GiovanniRaseraF/DroneTheory/Images/JeepRadiocomandata/Wiring.png

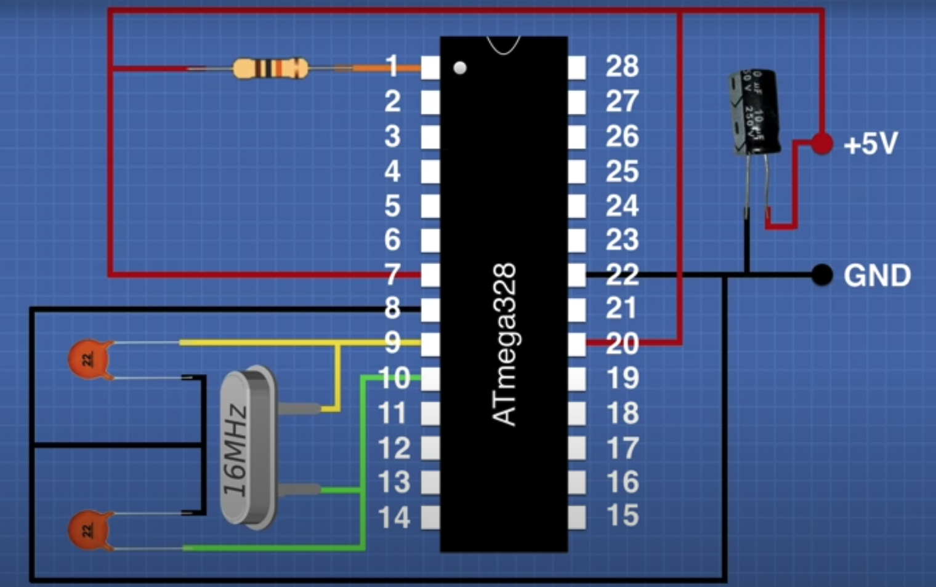
Images/JeepRadiocomandata/Wiring.png
