GiovanniRaseraF/DroneTheory/JeppRadiocomandataARDUINO/Schematica.jpeg

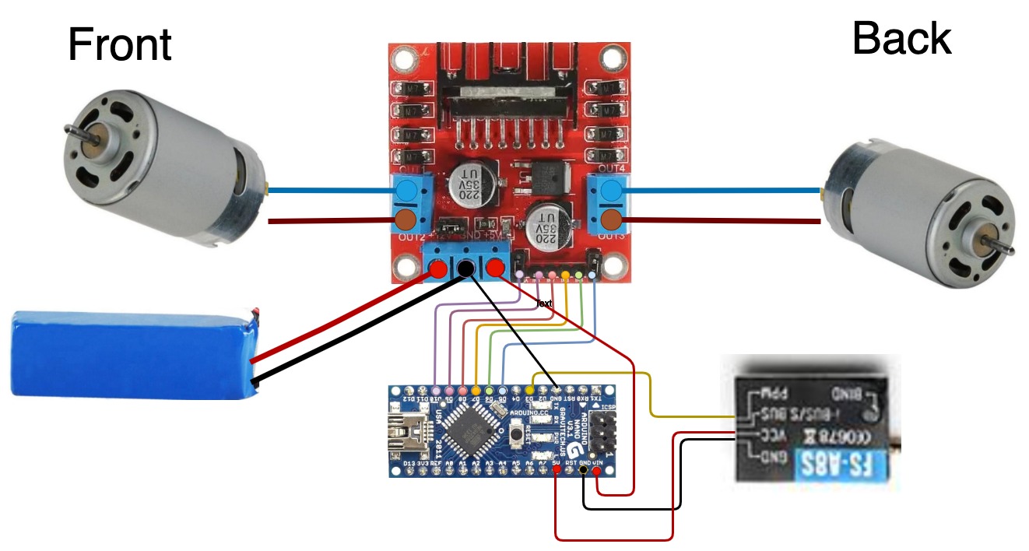
JeppRadiocomandataARDUINO/Schematica.jpeg
