GiovanniRaseraF/DroneTheory/README.md

# DroneTheory

Teoria e creazione di Flight Controller

Testing di ArduPilot
  - Creazione di un thread a 1Hz di esempio
  - Creazione di un esempio con hal.scheduler->register_timer_process(..)
  - RTOS 
  - DevCall Seguita 2022-08-16
