GiovanniRaseraF/DroneTheory/DronePCB/Vespin2/README.md

# Vespin 2.0

## Specifiche
- Convertitore da 5V a 3.3V
- Scheda PCB più grande
- PAD di connessione PWM e UART più grandi
- Test pad per la maggior parte delle connessioni 
- SWD con pad grandi per poter connettere i fili di debug
- Utilizzo di componenti 0603 oppure 0804 in modo da poterli saldare a mano

- Spostare la USB nella parte destra del processore in modo da non farla accavallare
- Connettere il giroscopio MPU6050, siccome costa 5 Euro su Amazon

- Passaggio ESP32 per comodità
