GiovanniRaseraF/DroneTheory/Ideas/prerequirements.md

# Prerequisiti

- Test del comando astyle
- Creazione del server per i test di CI
    - Probabilmente utilizzando docker per permettere di avere una VM più velocemente
- Capire come eseguire i test di compilazione nella macchina virtuale

# Arm ToolChain 
- File possibile per caricare la toolchain di arm [ToolChain](https://gist.github.com/ryankurte/bab66362f0c23d3a1916)
- Far funzionare la toolchain ed il download di essa
