GiovanniRaseraF/DroneTheory/Docs/publications.md

# Pubblicazioni che hanno contribuito
- [Alessandro Minervini, Development of an Open-Source Flight Controller for Rotary Wing UAVs. Rel. Giorgio Guglieri, Simone Godio. Politecnico di Torino, Corso di laurea magistrale in Ingegneria Aerospaziale, 2021](https://webthesis.biblio.polito.it/18388/)
  - Sull'intero lavoro
  - Sul codice sorgente
  - Funzioni di trasferimento del sistema di volo

- [Alessandro Lorenzini](https://github.com/alelore6)
  - Adattamento del file downlaod.sh 
  - Test per il download della toolchain arm

- [Matej Blagšič](https://github.com/prtzl)
  - Scrittura del file di configurazione della toolchain 
  - File cmake, make che permette di compilare i progetti STM32 da terminale usando cmake

- [Ryan](https://gist.github.com/ryankurte)
  - Scrittura del file di download.sh per il download della toolchain arm-none-eabi

- [PWM](https://www.google.com/search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)
  - Lezione sull'utilizzo del protocollo PWM su stm32

- [Collegamento FS-A8S](https://youtu.be/RERBbO7auhA)
  - Collegamento cavi a OMNIBUSF4 e impostazioni

- [Lettura PPM da radio trasmittente](https://github.com/dimag0g/PPM-reader)
  - Lettura del segnale e dei canali

- [ExpressLRS](https://github.com/ExpressLRS/ExpressLRS)
  - Protocollo di comunicazione open-source

- [ArduPilot](https://ardupilot.org/)
  - Firmware di volo
