GiovanniRaseraF/DroneTheory/Docs/RegoleDiVolo_A1+A3.pdf

# REQUEST FORM

### Request ID 332281

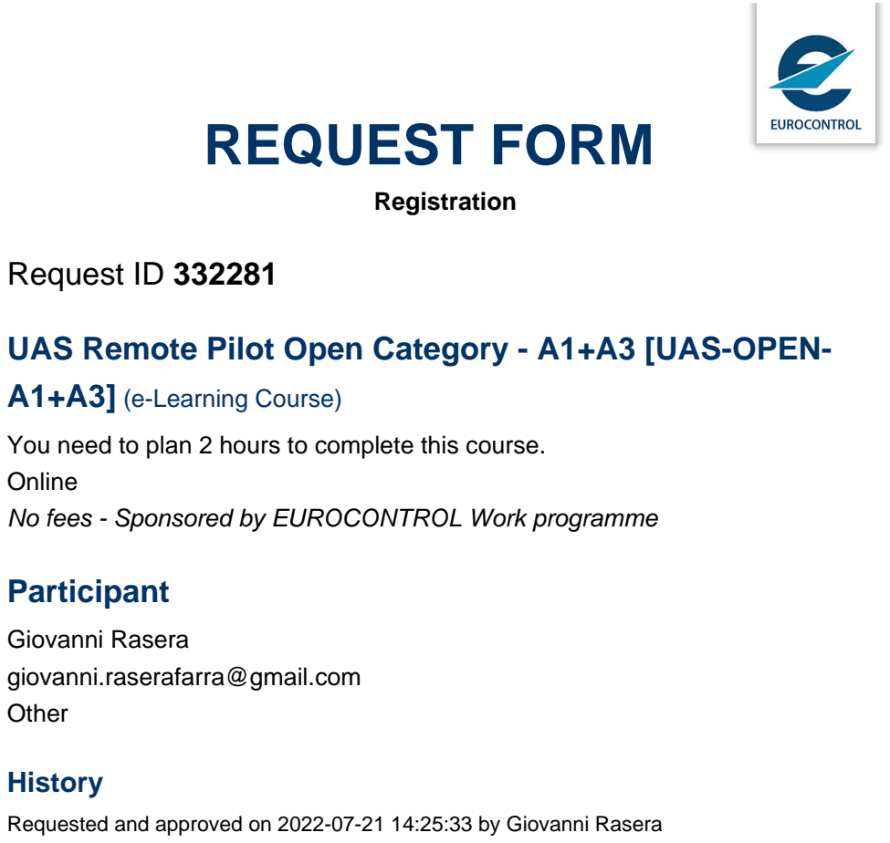
[picture p3: page 1]

Registration

## UAS Remote Pilot Open Category - A1+A3 [UAS-OPEN-

A1+A3] (e-Learning Course)

You need to plan 2 hours to complete this course.
Online
No fees - Sponsored by EUROCONTROL Work programme

## Participant

Giovanni Rasera
giovanni.raserafarra@gmail.com Other

History

Requested and approved on 2022-07-21 14:25:33 by Giovanni Rasera
