GiovanniRaseraF/DroneTheory/DronePCB/Images/AcquistoSchedaVespin1.0.PNG

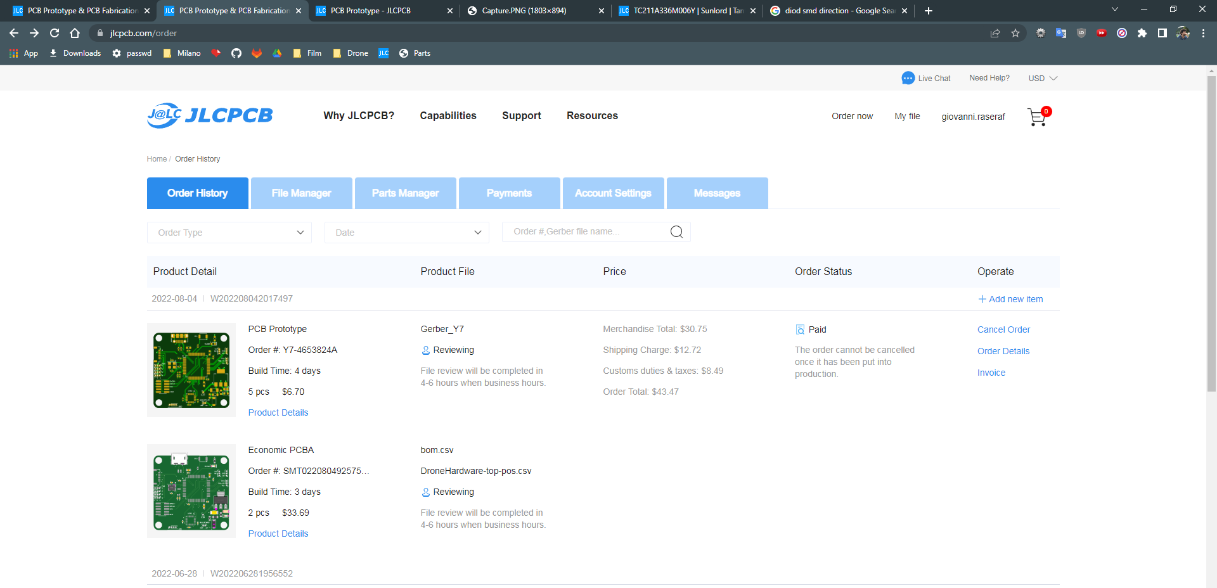
DronePCB/Images/AcquistoSchedaVespin1.0.PNG
