GiovanniRaseraF/DroneTheory/DronePCB/Images/Collegamento12Ve5V.PNG

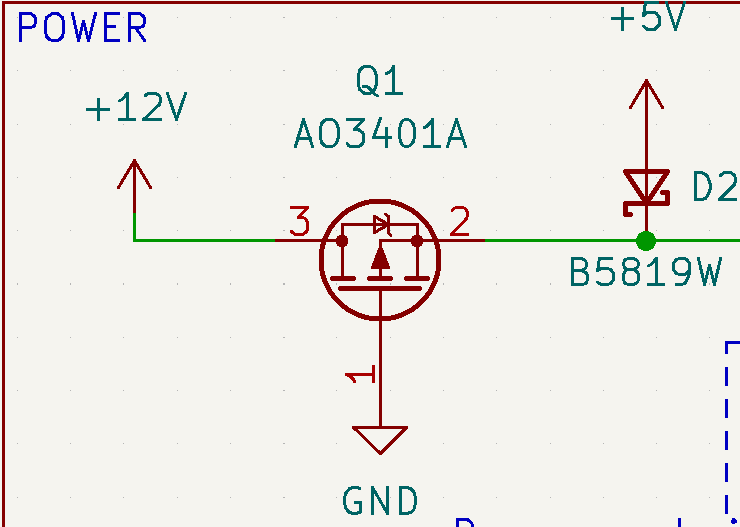
DronePCB/Images/Collegamento12Ve5V.PNG
