GiovanniRaseraF/DroneTheory/DronePCB/Images/LayoutProcessore.png

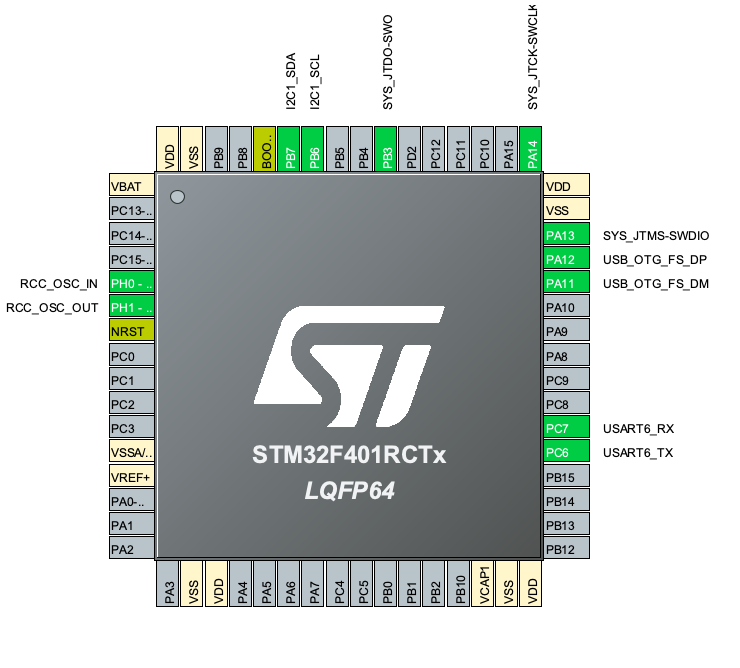
DronePCB/Images/LayoutProcessore.png
