GiovanniRaseraF/DroneTheory/DronePCB/Images/SWD_PIOUT.png

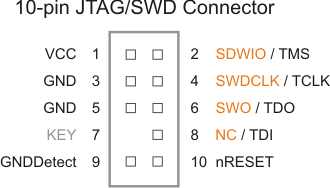
DronePCB/Images/SWD_PIOUT.png
