GiovanniRaseraF/DroneTheory/DronePCB/Manuals/STM32F405RGT6Pinout.png

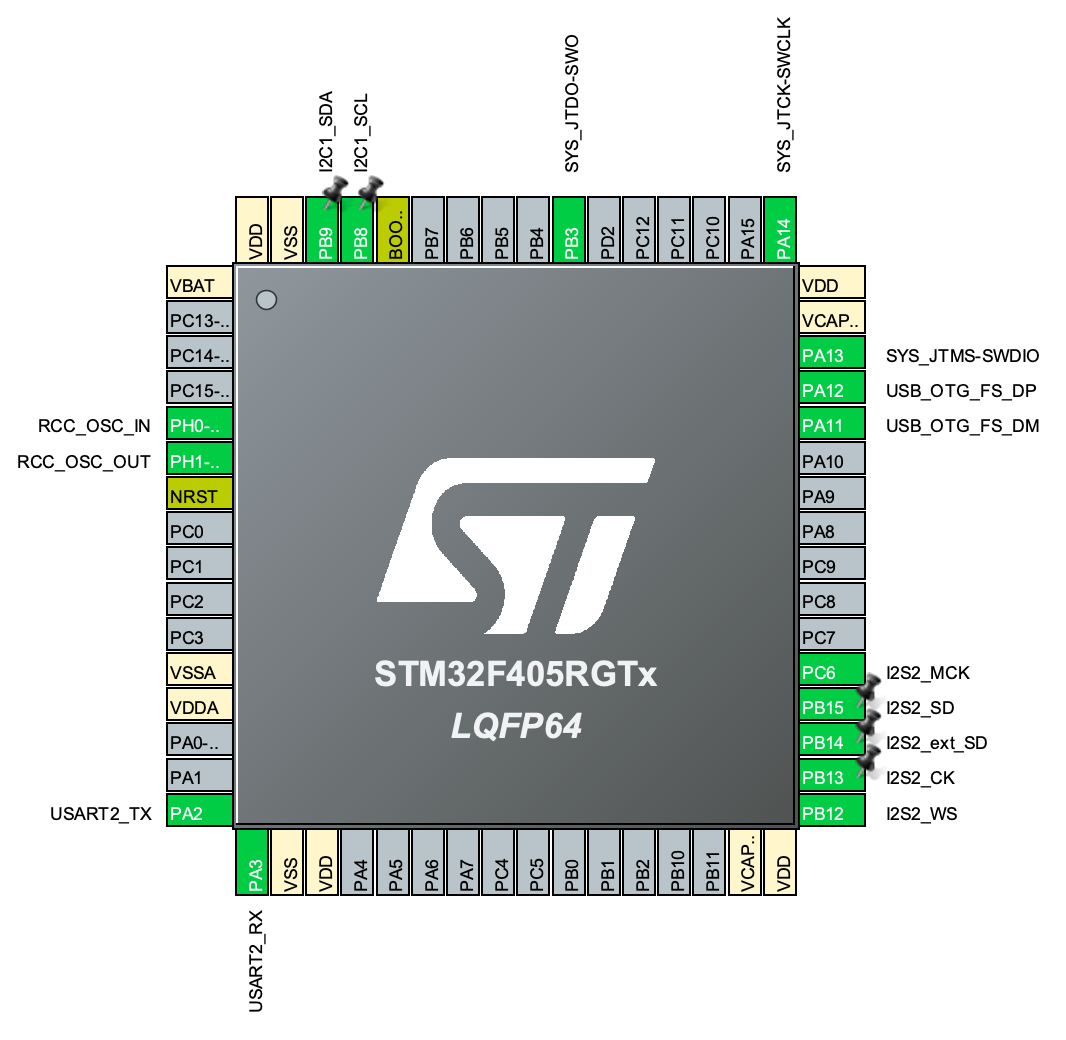
DronePCB/Manuals/STM32F405RGT6Pinout.png
