GiovanniRaseraF/DroneTheory/Images/JeepRadiocomandata/ArduinoNano.jpeg

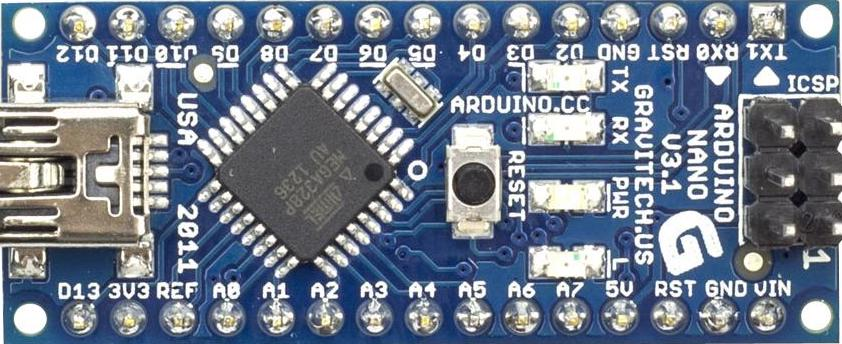
Images/JeepRadiocomandata/ArduinoNano.jpeg
