GiovanniRaseraF/DroneTheory/Images/JeepRadiocomandata/Battery.png

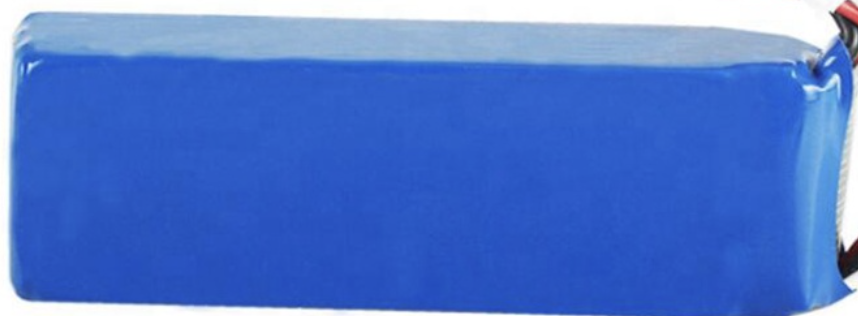
Images/JeepRadiocomandata/Battery.png
