GiovanniRaseraF/DroneTheory/Images/JeepRadiocomandata/collegamenti2.jpg

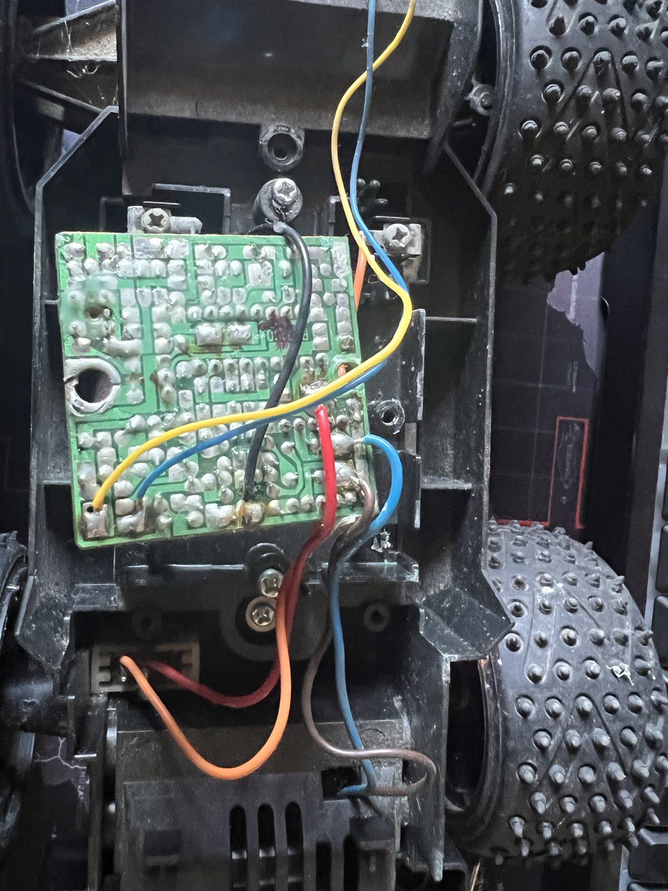
Images/JeepRadiocomandata/collegamenti2.jpg
