GiovanniRaseraF/DroneTheory/Images/JeepRadiocomandata/collegamenti.jpg

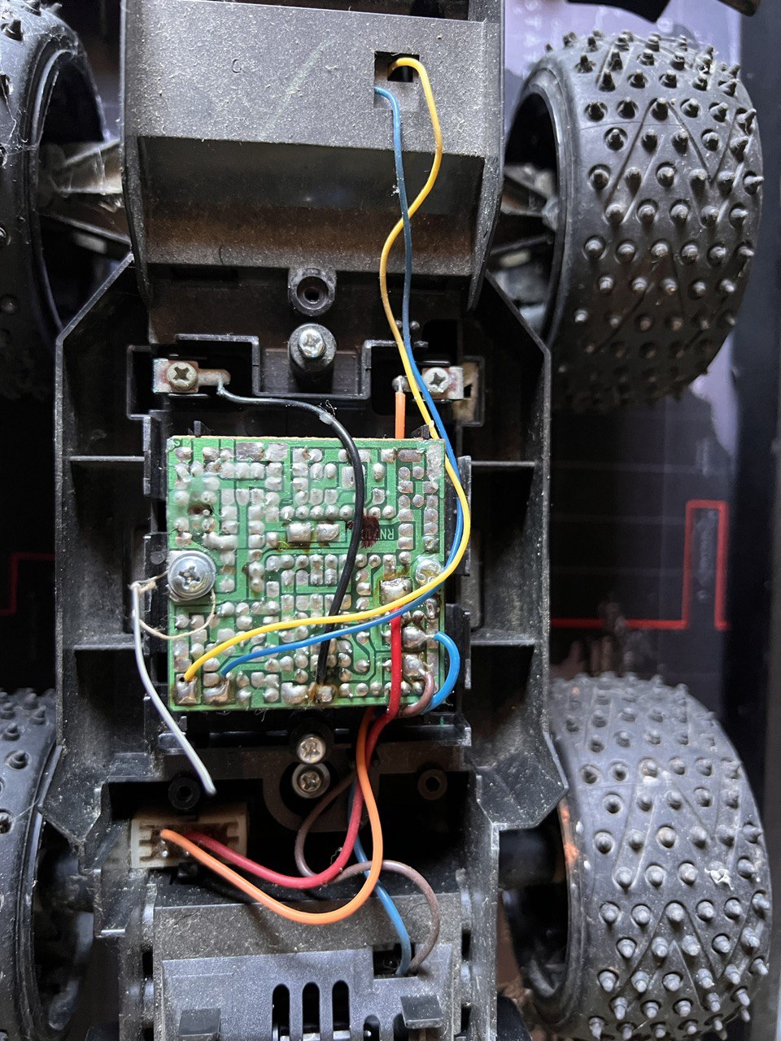
Images/JeepRadiocomandata/collegamenti.jpg
