GiovanniRaseraF/DroneTheory/Images/JeepRadiocomandata/CollegamentoATmega328.png

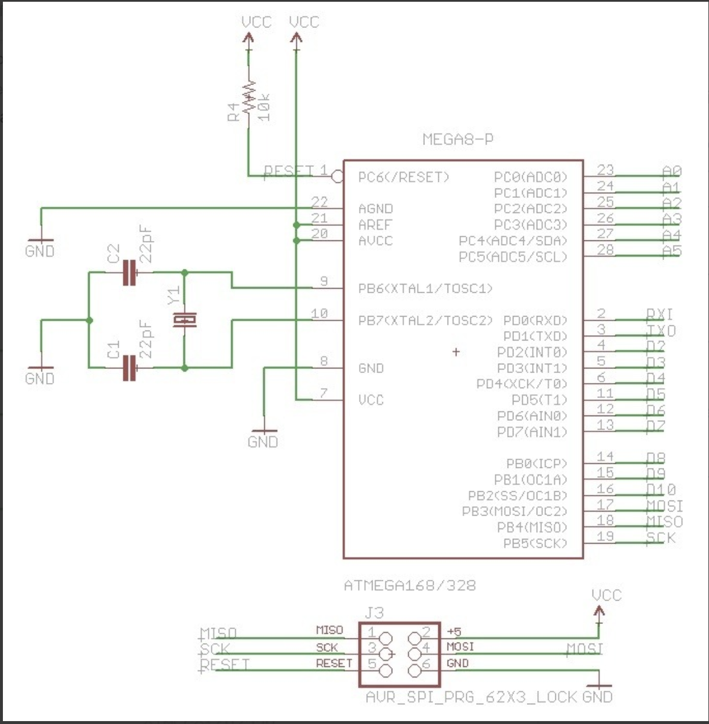
Images/JeepRadiocomandata/CollegamentoATmega328.png
