GiovanniRaseraF/DroneTheory/Images/JeepRadiocomandata/DriverMotoreBack.jpg

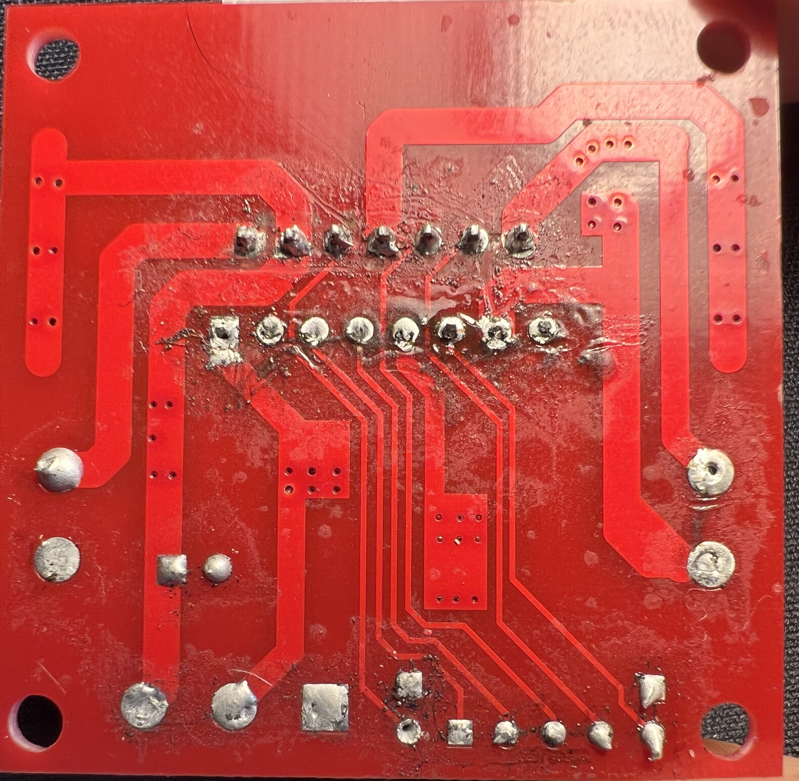
Images/JeepRadiocomandata/DriverMotoreBack.jpg
