GiovanniRaseraF/DroneTheory/Images/JeepRadiocomandata/DriverMotoreFront.jpg

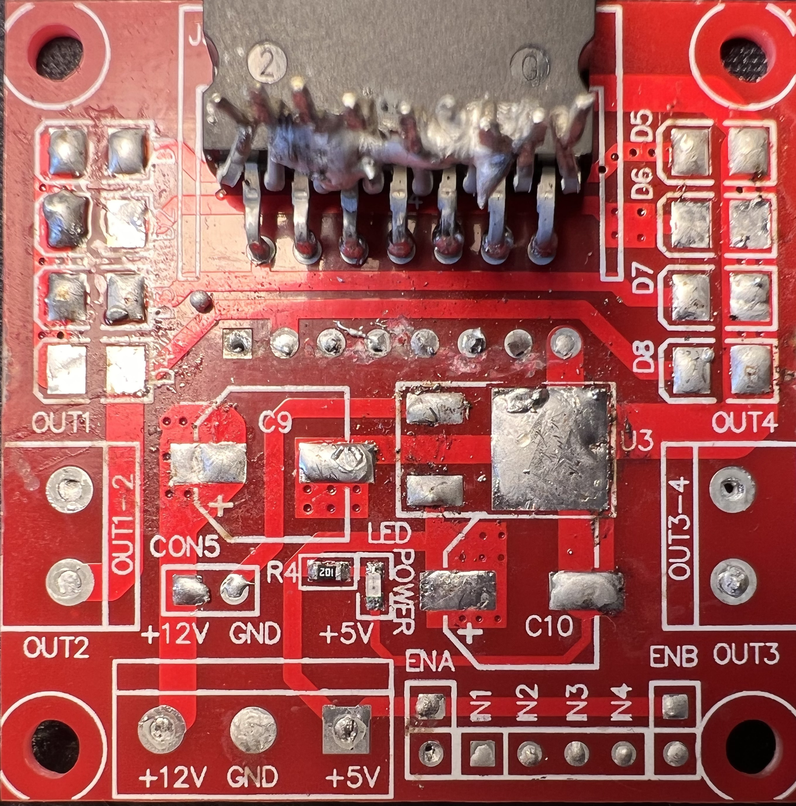
Images/JeepRadiocomandata/DriverMotoreFront.jpg
