GiovanniRaseraF/DroneTheory/Images/JeepRadiocomandata/FS-A8S.png

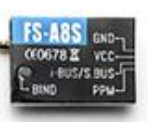
Images/JeepRadiocomandata/FS-A8S.png
