GiovanniRaseraF/DroneTheory/Images/JeepRadiocomandata/jeppRadiocomandataArduino.jpg

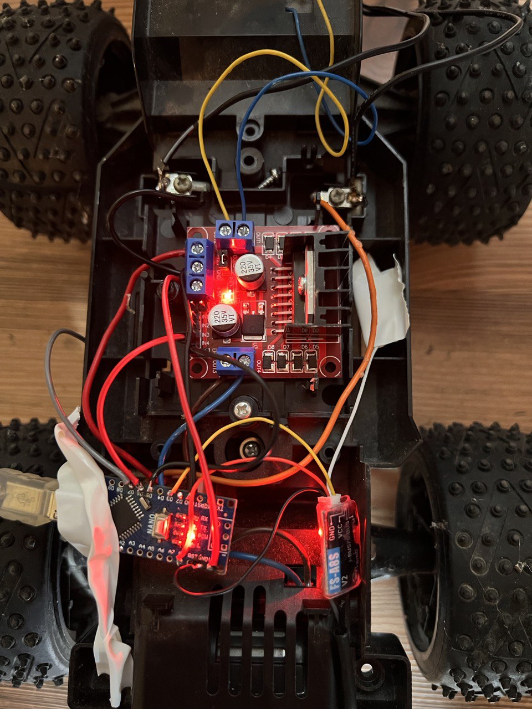
Images/JeepRadiocomandata/jeppRadiocomandataArduino.jpg
