GiovanniRaseraF/DroneTheory/Images/JeepRadiocomandata/L298NModulo.jpg

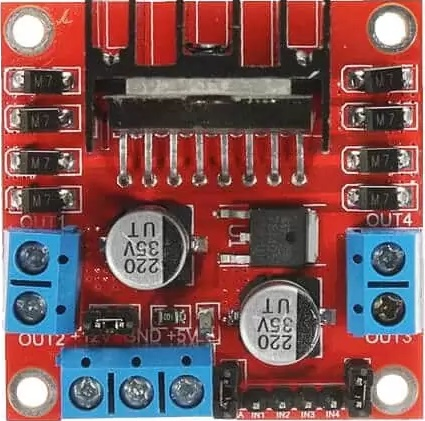
Images/JeepRadiocomandata/L298NModulo.jpg
