GiovanniRaseraF/DroneTheory/Images/JeepRadiocomandata/L298NModuloSchematica.png

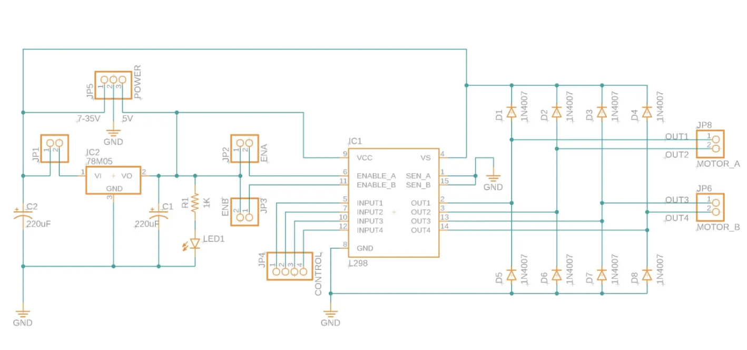
Images/JeepRadiocomandata/L298NModuloSchematica.png
