GiovanniRaseraF/DroneTheory/Images/JeepRadiocomandata/Motor.png

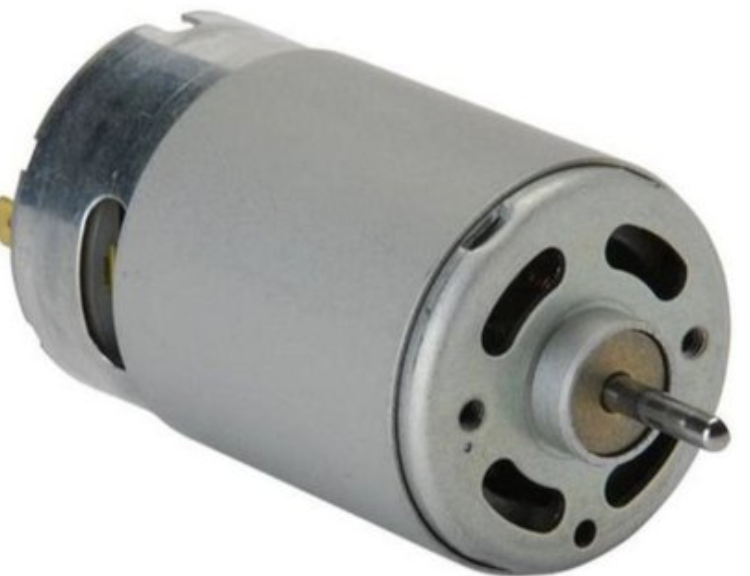
Images/JeepRadiocomandata/Motor.png
