GiovanniRaseraF/DroneTheory/Images/MatekF405/matekf405.jpeg

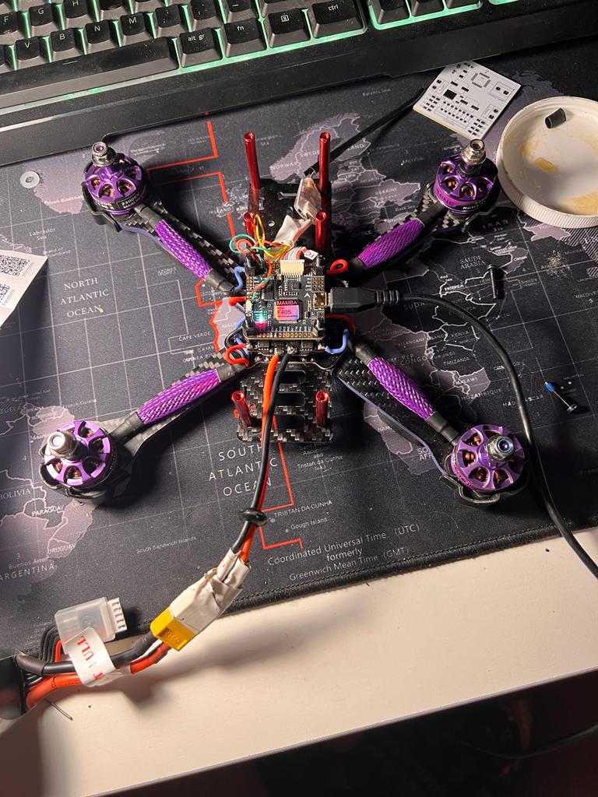
Images/MatekF405/matekf405.jpeg
