GiovanniRaseraF/DroneTheory/Images/taillessplane.png

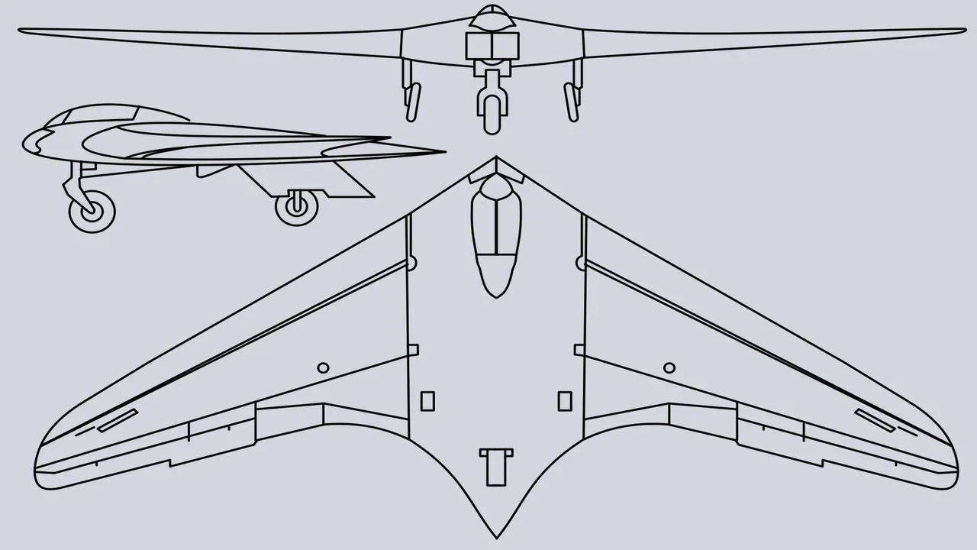
Images/taillessplane.png
