GiovanniRaseraF/DroneTheory/Images/VespinVer1.0/PCBBack.PNG

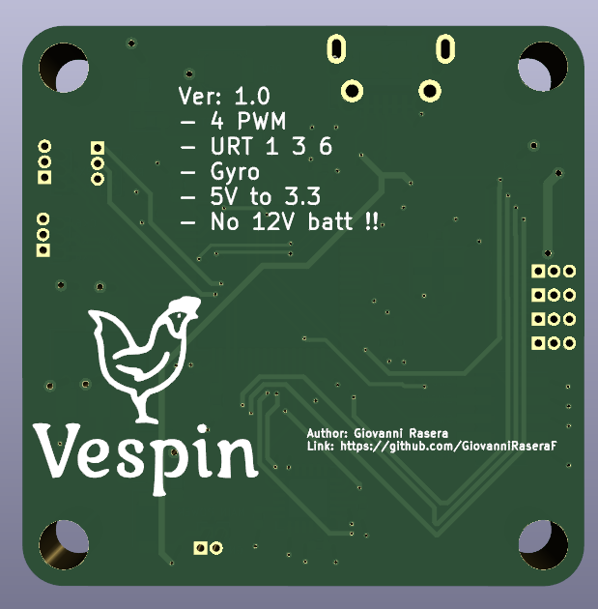
Images/VespinVer1.0/PCBBack.PNG
