GiovanniRaseraF/DroneTheory/Images/VespinVer1.0/PCBFront.PNG

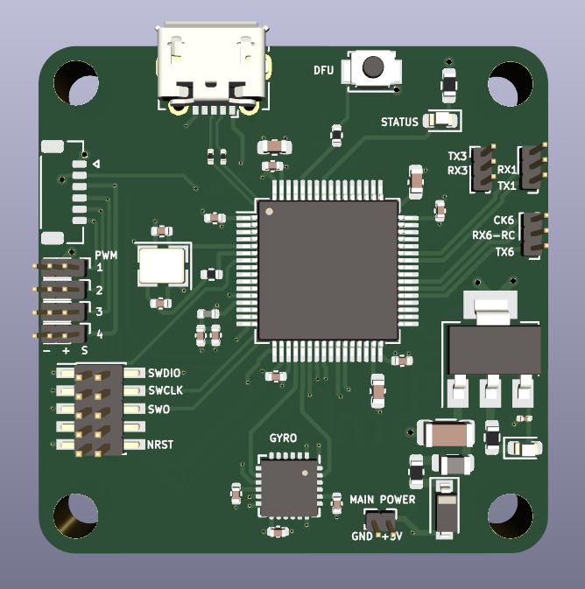
Images/VespinVer1.0/PCBFront.PNG
