GiovanniRaseraF/DroneTheory/JeppRadiocomandataARDUINO/Hardware/1.0.0/Front_JeepPCB.jpg

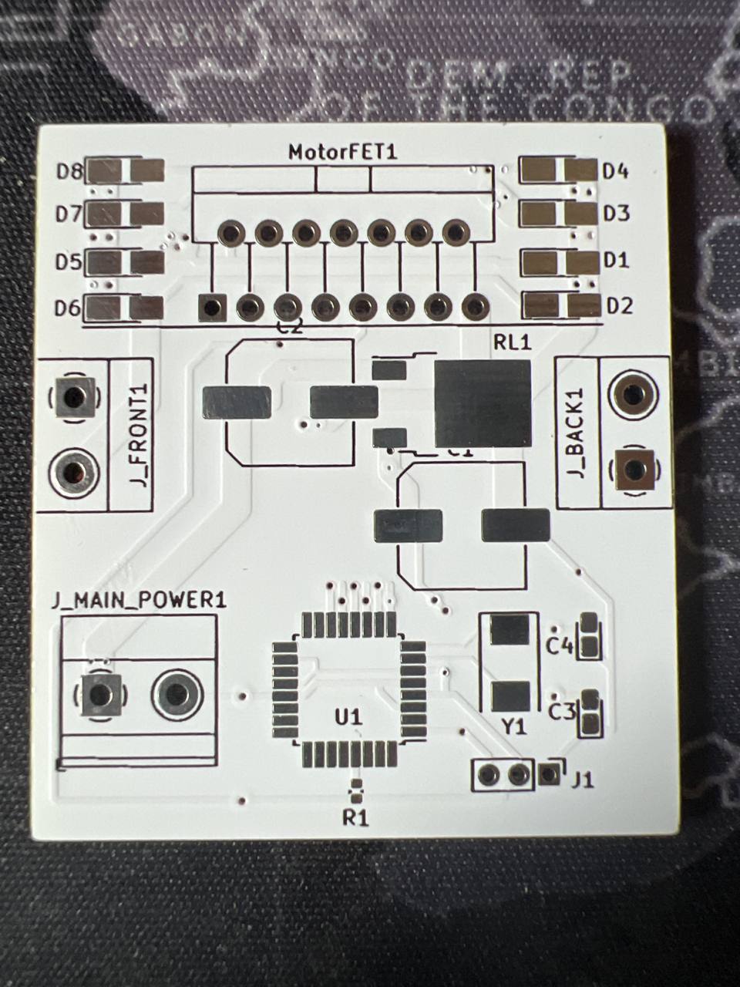
JeppRadiocomandataARDUINO/Hardware/1.0.0/Front_JeepPCB.jpg
