GiovanniRaseraF/DroneTheory/DronePCB/HWCorso/HWCorso.csv

Source: | /Users/giovannirasera/repos/DroneTheory/SingleTests/STM32CubeIDETest/CorsoKiCad/Hardware/HWCorso/HWCorso.kicad_sch
Date: | 2022 July 05, Tuesday 18:37:32
Tool: | Eeschema (6.0.5-0)
Generator: | /Applications/KiCad/KiCad.app/Contents/SharedSupport/plugins/bom_csv_grouped_by_value_with_fp.py
Component Count: | 48
Ref | Qnty | Value | Cmp name | Footprint | Description | Vendor
C1, | 1 | 4u7 | C_Small | Capacitor_SMD:C_0603_1608Metric | Unpolarized capacitor, small symbol
C2, | 1 | 2u2 | C_Small | Capacitor_SMD:C_0603_1608Metric | Unpolarized capacitor, small symbol
C3, C4, C5, C7, C14, | 5 | 100n | C_Small | Capacitor_SMD:C_0402_1005Metric | Unpolarized capacitor, small symbol
C6, | 1 | 10U | C_Small | Capacitor_SMD:C_1206_3216Metric | Unpolarized capacitor, small symbol
C8, | 1 | 1u | C_Small | Capacitor_SMD:C_0402_1005Metric | Unpolarized capacitor, small symbol
C9, C11, | 2 | 12p | C_Small | Capacitor_SMD:C_0402_1005Metric | Unpolarized capacitor, small symbol
C10, | 1 | 10n | C_Small | Capacitor_SMD:C_0402_1005Metric | Unpolarized capacitor, small symbol
C12, | 1 | 10n | C_Small | Capacitor_SMD:C_0603_1608Metric | Unpolarized capacitor, small symbol
C13, | 1 | 22u | C_Small | Capacitor_SMD:C_1206_3216Metric | Unpolarized capacitor, small symbol
D1, | 1 | BLUE | LED_Small | LED_SMD:LED_0603_1608Metric | Light emitting diode, small symbol
D2, D3, | 2 | B5819W | D_Schottky_Small | Diode_SMD:D_SOD-123 | Schottky diode, small symbol
D4, | 1 | RED | LED_Small | LED_SMD:LED_0603_1608Metric | Light emitting diode, small symbol
F1, | 1 | 250mA | Polyfuse_Small | Fuse:Fuse_0603_1608Metric | Resettable fuse, polymeric positive temperature coefficient, small symbol
FB1, | 1 | 600 @ 600MHz | FerriteBead_Small | Inductor_SMD:L_0805_2012Metric | Ferrite bead, small symbol
H1, H2, H3, H4, | 4 | MountingHole_Pad | MountingHole_Pad | MountingHole:MountingHole_4.3mm_M4_Pad_Via | Mounting Hole with connection
J1, | 1 | USB_B_Mini | USB_B_Mini | Connector_USB:USB_Mini-B_Wuerth_65100516121_Horizontal | USB Mini Type B connector
J2, | 1 | BATTERY | Screw_Terminal_01x02 | TerminalBlock_Phoenix:TerminalBlock_Phoenix_PT-1,5-2-3.5-H_1x02_P3.50mm_Horizontal | Generic screw terminal, single row, 01x02, script generated (kicad-library-utils/schlib/autogen/connector/)
J3, | 1 | I2C_CONN | Conn_01x04 | Connector_Molex:Molex_PicoBlade_53048-0410_1x04_P1.25mm_Horizontal | Generic connector, single row, 01x04, script generated (kicad-library-utils/schlib/autogen/connector/)
J4, | 1 | SWD_CONN | Conn_02x05_Odd_Even | Connector_PinHeader_1.27mm:PinHeader_2x05_P1.27mm_Vertical_SMD | Generic connector, double row, 02x05, odd/even pin numbering scheme (row 1 odd numbers, row 2 even numbers), script generated (kicad-library-utils/schlib/autogen/connector/)
J5, | 1 | USART6_CONN | Conn_01x04 | Connector_Molex:Molex_PicoBlade_53048-0410_1x04_P1.25mm_Horizontal | Generic connector, single row, 01x04, script generated (kicad-library-utils/schlib/autogen/connector/)
L1, | 1 | 39n | L_Small | Inductor_SMD:L_0402_1005Metric | Inductor, small symbol
L2, | 1 | 10u | L_Small | Inductor_SMD:L_Sunlord_MWSA0518_5.4x5.2mm | Inductor, small symbol
Q1, | 1 | AO3401A | AO3401A | Package_TO_SOT_SMD:SOT-23 | -4.0A Id, -30V Vds, P-Channel MOSFET, SOT-23
R1, | 1 | 1K5 | R_Small | Resistor_SMD:R_0603_1608Metric | Resistor, small symbol
R2, | 1 | 100K | R_Small | Resistor_SMD:R_0603_1608Metric | Resistor, small symbol
R3, | 1 | 68K | R_Small | Resistor_SMD:R_0603_1608Metric | Resistor, small symbol
R4, | 1 | 10K | R_Small | Resistor_SMD:R_0402_1005Metric | Resistor, small symbol
R5, R7, | 2 | 2k2 | R_Small | Resistor_SMD:R_0603_1608Metric | Resistor, small symbol
R6, | 1 | 47 | R_Small | Resistor_SMD:R_0402_1005Metric | Resistor, small symbol
R8, | 1 | 47K | R_Small | Resistor_SMD:R_0603_1608Metric | Resistor, small symbol
R9, | 1 | 15K | R_Small | Resistor_SMD:R_0603_1608Metric | Resistor, small symbol
R10, | 1 | 270 | R_Small | Resistor_SMD:R_0603_1608Metric | Resistor, small symbol
R11, | 1 | 1K | R_Small | Resistor_SMD:R_0603_1608Metric | Resistor, small symbol
SW1, | 1 | SW_SPDT | SW_SPDT | Button_Switch_SMD:SW_SPDT_PCM12 | Switch, single pole double throw
U1, | 1 | STM32F401RCT6 | STM32F401RCTx | Package_QFP:LQFP-64_10x10mm_P0.5mm | ARM Cortex-M4 MCU, 256KB flash, 64KB RAM, 84MHz, 1.7-3.6V, 50 GPIO, LQFP-64
U2, | 1 | MP2359DJ-LF-Z | MP2359DJ-LF-Z | Package_TO_SOT_SMD:SOT-23-6
U3, | 1 | USBLC6-2SC6 | USBLC6-2SC6 | Package_TO_SOT_SMD:SOT-23-6 | Very low capacitance ESD protection diode, 2 data-line, SOT-23-6
Y1, | 1 | 16MHz | Crystal_GND24 | Crystal:Crystal_SMD_3225-4Pin_3.2x2.5mm | Four pin crystal, GND on pins 2 and 4
