GiovanniRaseraF/DroneTheory/DronePCB/TestConNicola/Footprints/LM3940IMP-3.3_NOPB.step

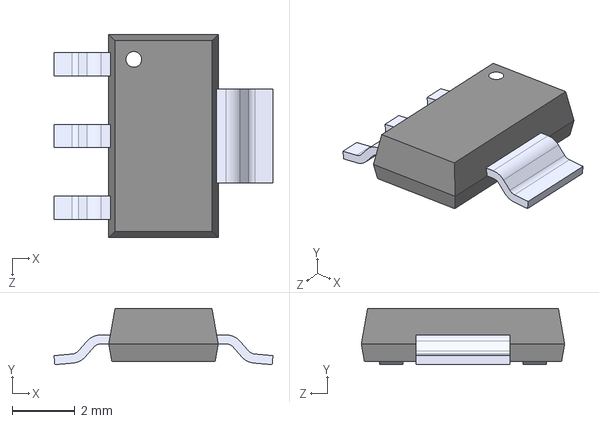
[picture p26: CAD file, 2022-07-10]
DronePCB/TestConNicola/Footprints/LM3940IMP-3.3_NOPB.step
7.00 x 1.80 x 6.50 mm
