GiovanniRaseraF/DroneTheory/JeppRadiocomandataARDUINO/Hardware/JeepPCB/3DComponents/Transistor L298N.step

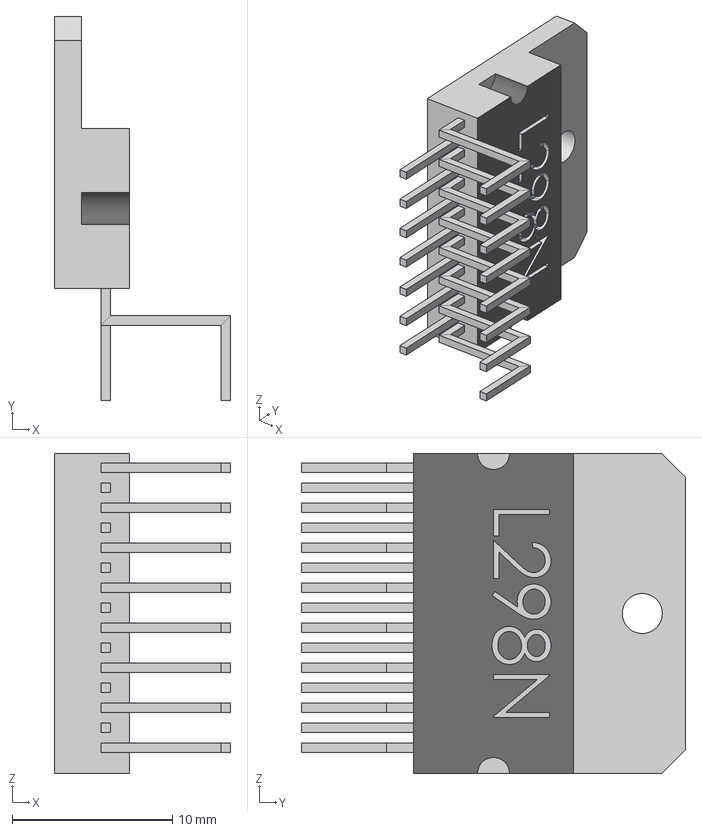
[picture p27: CAD file, 2022-06-18]
JeppRadiocomandataARDUINO/Hardware/JeepPCB/3DComponents/Transistor L298N.step
11.0 x 24.0 x 20.0 mm
