GiovanniRaseraF/DroneTheory/SingleTests/STM32CubeIDETest/CorsoKiCad/FootPrint/STM32F401RCT6.step

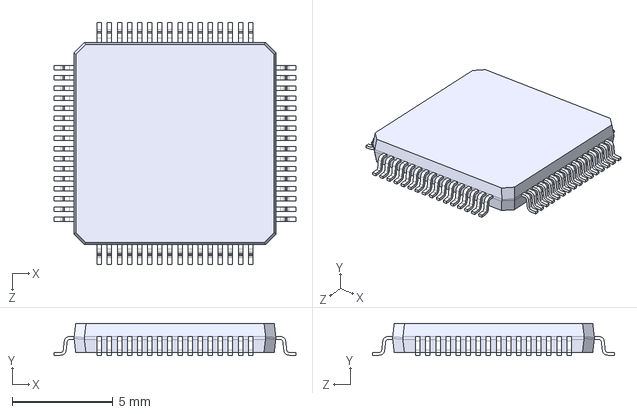
[picture p28: CAD file, 2022-06-30]
SingleTests/STM32CubeIDETest/CorsoKiCad/FootPrint/STM32F401RCT6.step
12.0 x 1.60 x 12.0 mm
