GiovanniRaseraF/DroneTheory/Images/VespinVer1.0/Wiring.PNG

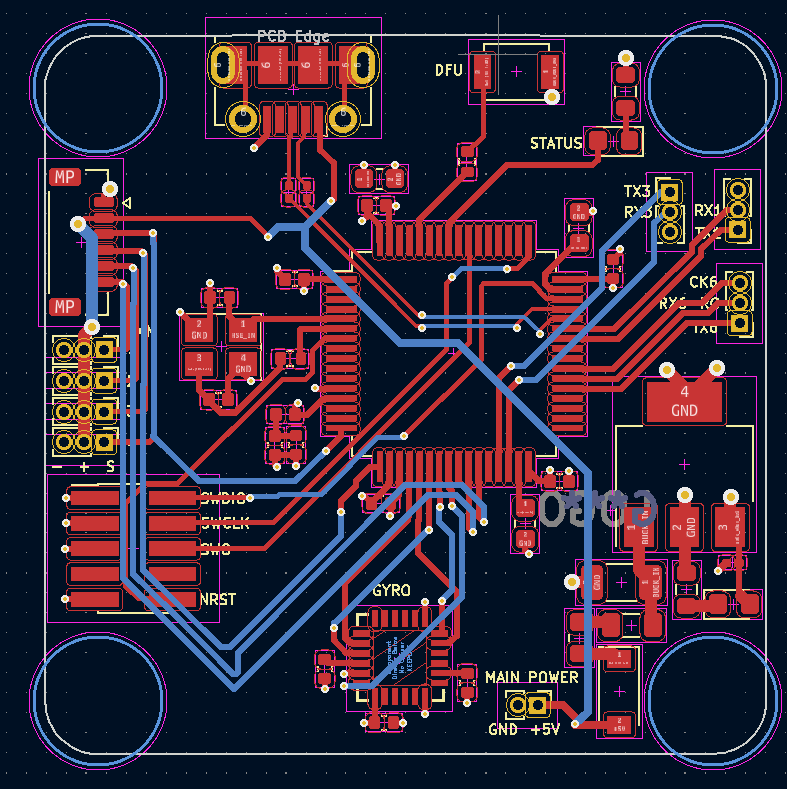
Images/VespinVer1.0/Wiring.PNG
