GiovanniRaseraF/DroneTheory/TODO.md

# DroneTheory

- Jeep Radiocomandata, PCB e software
- PCB del drone, versione con convertitore da 12V a 3.3V
- PCB del drone, versione con convertitore da 5V a 3.3V

## Contribuzione a ArduPilot

## TODO:
- Scadenza: 01/08/2022
- Stampare il PCB del drone, versione da 5V a 3.3V
    - Revisione dei collegamenti
    - Creazione del BOM
    - Creazione della posizione dei componenti
    - Creazione della scheda di alimentazione semparata
    - Capire che componente è il L8V di OMNIBUSF4
    
    - Utilizzo di ArduPilot
    - Studiare ArduPilot
