GiovanniRaseraF/DroneTheory/(threads)

Thread 3 (2022-05-28):

File di download della toolchain arm non funzionante

GiovanniRaseraF, 2022-05-28:
Il file sotto la cartella di test [download.sh](https://github.com/GiovanniRaseraF/DroneTheory/blob/main/SingleTests/ToolChainDownloadTest/download.sh) non scarica la toolchain corretta per linux x86

In particolare queste sono le linee di codice che dovrebbero contenere il link sbagliato:
```bash
# Toolchain base URL
# example: https://launchpad.net/gcc-arm-embedded/4.9/4.9-2015-q1-update/+download/gcc-arm-none-eabi-4_9-2015q1-20150306-win32.zip
TOOLCHAIN_ADDR="https://launchpad.net/gcc-arm-embedded/${TOOLCHAIN_VERSION_MAJOR}.${TOOLCHAIN_VERSION_MINOR}/${TOOLCHAIN_VERSION_MAJOR}.${TOOLCHAIN_VERSION_MINOR}-${TOOLCHAIN_YEAR}-q${TOOLCHAIN_QUARTER}-update/+download/"
```

Da testare il download da un diverso sito con l'aggiunta di un test di verifica che la toolchain sia compatibile con il SO su cui si è scaricata

GiovanniRaseraF, 2022-05-30:
Grazie Alessandro.

Closed 2022-05-30.

Thread 5 (2022-05-30):

download.sh non funziona su macOS

GiovanniRaseraF, 2022-05-30:
Il file di download della toolchain non funziona correttamente su mac siccome l'architettura non è x86 ma arm

Il codice di interesse è questo:
```bash
TOOLCHAIN_BASE="gcc-arm-none-eabi-10.3-2021.10-x86_64"
```

non deve contenere il riferimento all'architettura, questa deve essere estratta in seguito

GiovanniRaseraF, 2022-06-03:
E' stato risolto togliendo il prefisso dell'architettura.
Ora il file di download.sh funziona su macOS e su WSL che per ora è abbastanza.

Closed 2022-06-03.

Thread 6 (2022-05-30):

Passare a CMake

GiovanniRaseraF, 2022-05-30:
Per il download della toolchain meglio passare a CMake.

In futuro.

GiovanniRaseraF, 2022-06-03:
Il passaggio è stato fatto, e i test sono presenti in: [CMakeOnSTM32](https://github.com/GiovanniRaseraF/DroneTheory/tree/main/SingleTests/CMakeOnSTM32)

Non è possibile compilare tutto ma solamente il test per ora

Closed 2022-06-03.

Thread 7 (2022-07-10):

Meglio non utilizzare i 12V dalla batteria

GiovanniRaseraF, 2022-07-10:
Il regolatore da 12V a 3.3V occupa molto spazio nel pcb, quindi meglio utilizzare LM3940 1-A Low-Dropout Regulator for 5-V to 3.3-V Conversion.

GiovanniRaseraF, 2022-07-26:
Il problema è stato risolto ma non testato.
Link alla versione con conversione 5V -> 3.3V: [Versione 5V -> 3.3V](https://github.com/GiovanniRaseraF/DroneTheory/tree/main/DronePCB/5V_DroneHardware)

Closed 2022-07-26.

Thread 8 (2022-07-26):

Alimentazione della radio ricevente

GiovanniRaseraF, 2022-07-26:
La radio ricevente viene alimentata da 5V, il problema è che in OMNIBUSF4 non è presente una connessione diretta tra i 5V di alimentazione del FC a i 5V che alimentano la ricevente radio.

Importante trovare come alimentare la ricevente.

Closed 2022-08-01.

Thread 10 (2022-07-27):

Utilizzando conversione da 5V a 3.3V potrebbero verificarsi problemi di sottovoltaggio

GiovanniRaseraF, 2022-07-27:
Questo va verificato collegando i 12V al FC e vedere se i voltaggi sono gli stessi sotto stress.

GiovanniRaseraF, 2022-08-01:
Le schede funzionano anche con 5V in input, non ci dovrebbero essere problemi.

Closed 2022-08-01.

Thread 12 (2022-08-02):

5V dalla batteria possono andare in conflitto con i 5V dalla porta USB

GiovanniRaseraF, 2022-08-02:

GiovanniRaseraF, 2022-08-04:
E' stato eseguito un test di collegamento e il problema non è presente, questo significa che è possibile collegare i 5V dall'ESC ai 5V della porta USB

Thread 13 (2022-08-04):

Non è presente la direzione del PCB

GiovanniRaseraF, 2022-08-04:
Non è presente il verso avanti della Scheda, nella prossima versione va aggiunta.
[Immagine](https://github.com/GiovanniRaseraF/DroneTheory/blob/main/DronePCB/Images/AcquistoSchedaVespin1.0.PNG)

Thread 14 (2022-08-18):

Stampa di vie a diametro 0.2mm ha un costo superiore

GiovanniRaseraF, 2022-08-18:
JLCPCB fa aumentare il costo della stampa di PCB con vie a diametro 0.2mm questo perché il 4 WIRES KELVIN TEST è più complicato.

GiovanniRaseraF, 2022-08-18:
La soluzione è portare tutte le vie a diametro 0.4 o 0.5, farle più grandi possibile

Thread 17 (2022-09-08):

Lista dei priblemi di Vespin 1.0

GiovanniRaseraF, 2022-09-08:
- Componenti troppo piccole (condensatori e restistenze)
- Impossibile da flashare con USB
- Convertitore da 5V a 3.3V funziona ma è soggetto a corto circuito
- Il componente C102 (condensatore a 33uF) nella sezione di conversione da 5V a 3.3V ha il footprint sbagliato
- Le tracce sono troppo piccole, vanno aumentate
- I punti in cui si collegano i PWM e UART sono troppo piccoli (IMPOSSIBILI DA SALDARE CAVI)

GiovanniRaseraF, 2022-09-10:
+
- Il timer esterno non funziona
- L'esecuzione di HAL_Delay() causa un errore e blocca la scheda
- L'esecuzione di un qualsiasi tipo di codice ad una velocità altra porta il ad un errore e shutdown del processore
      - https://www.youtube.com/watch?v=5LEWEGjB-Kk
      - https://www.youtube.com/watch?v=yRQxqhp5d5c
      - https://www.youtube.com/shorts/usCuFa-BmkU

GiovanniRaseraF, 2022-09-11:
La funzione SysTick_Handler() non viene chiamata dopo che vine generato l'interrupt.
Controllare che:
   - I bit per attivare l'interrupt del timer siano attivi [4.4.5 SysTick usage hints and tips](https://github.com/GiovanniRaseraF/DroneTheory/blob/main/Docs/DUI0553.pdf)
   - Altre eccezioni funzionino (UserFault, ...)
