GiovanniRaseraF/DroneTheory/JeppRadiocomandataARDUINO/Hardware/JeepPCB_Print.pdf

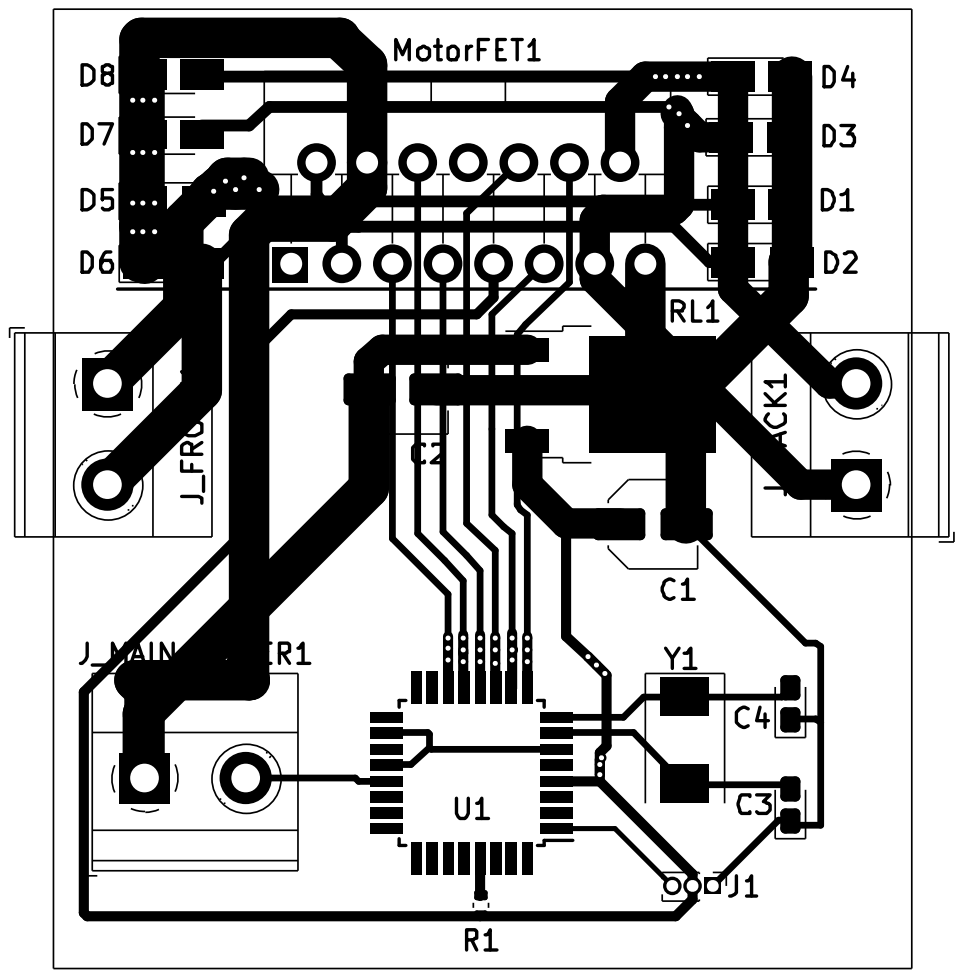
[picture p30: page 1]
