GiovanniRaseraF/DroneTheory/Docs/Categories_a_legacy_drone_may_be_flown_in.pdf

OK | OK | OK

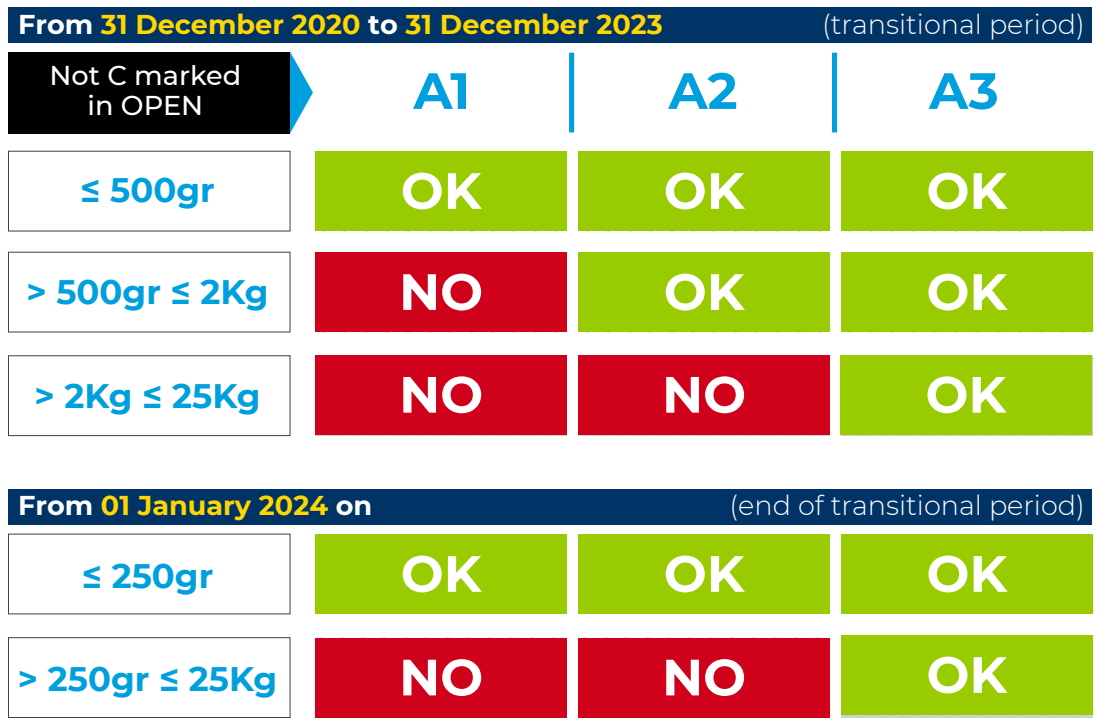
[picture p31: page 1]
Not C marked; in OPEN; From 31 December 2020 to 31 December 2023; (transitional period); From 01 January 2024 on; (end of transitional period)
