GiovanniRaseraF/DroneTheory/DronePCB/TestConNicola/DroneHardware.kicad_pcb

## KiCad design DronePCB/TestConNicola/DroneHardware.kicad_pcb (2022-09-29)

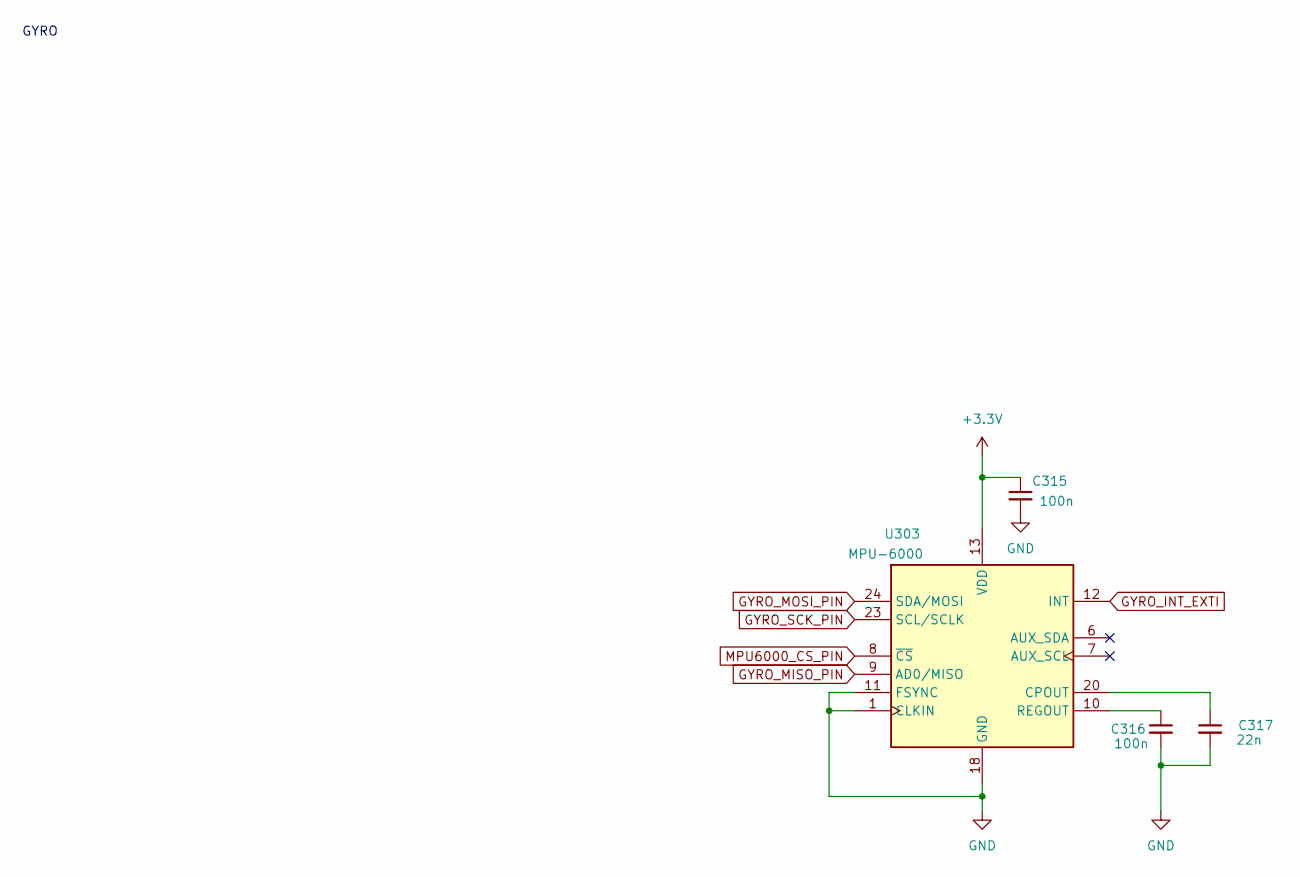
[picture p32: schematic Gyro.kicad_sch]

Parts:
C315, C316: 100n; C_0402_1005Metric; LCSC Part # C15195
C317: 22n; C_0402_1005Metric; LCSC Part # C1532
U303: MPU-6000; InvenSense_QFN-24_4x4mm_P0.5mm; LCSC Part # C92401

Connections:
BUCK_VOUT_3V3: C315.1, U303.13 (VDD); also elsewhere on the board
GND: C315.2, C316.2, C317.2, U303.1 (CLKIN), U303.11 (FSYNC), U303.18 (GND); also elsewhere on the board
GYRO_INT_EXTI: U303.12 (INT); also elsewhere on the board
GYRO_MISO_PIN: U303.9 (AD0/MISO); also elsewhere on the board
GYRO_MOSI_PIN: U303.24 (SDA/MOSI); also elsewhere on the board
GYRO_SCK_PIN: U303.23 (SCL/SCLK); also elsewhere on the board
MPU6000_CS_PIN: U303.8 (~CS); also elsewhere on the board
unnamed: C316.1, U303.10 (REGOUT)
unnamed: C317.1, U303.20 (CPOUT)

Notes on the sheet:
GYRO

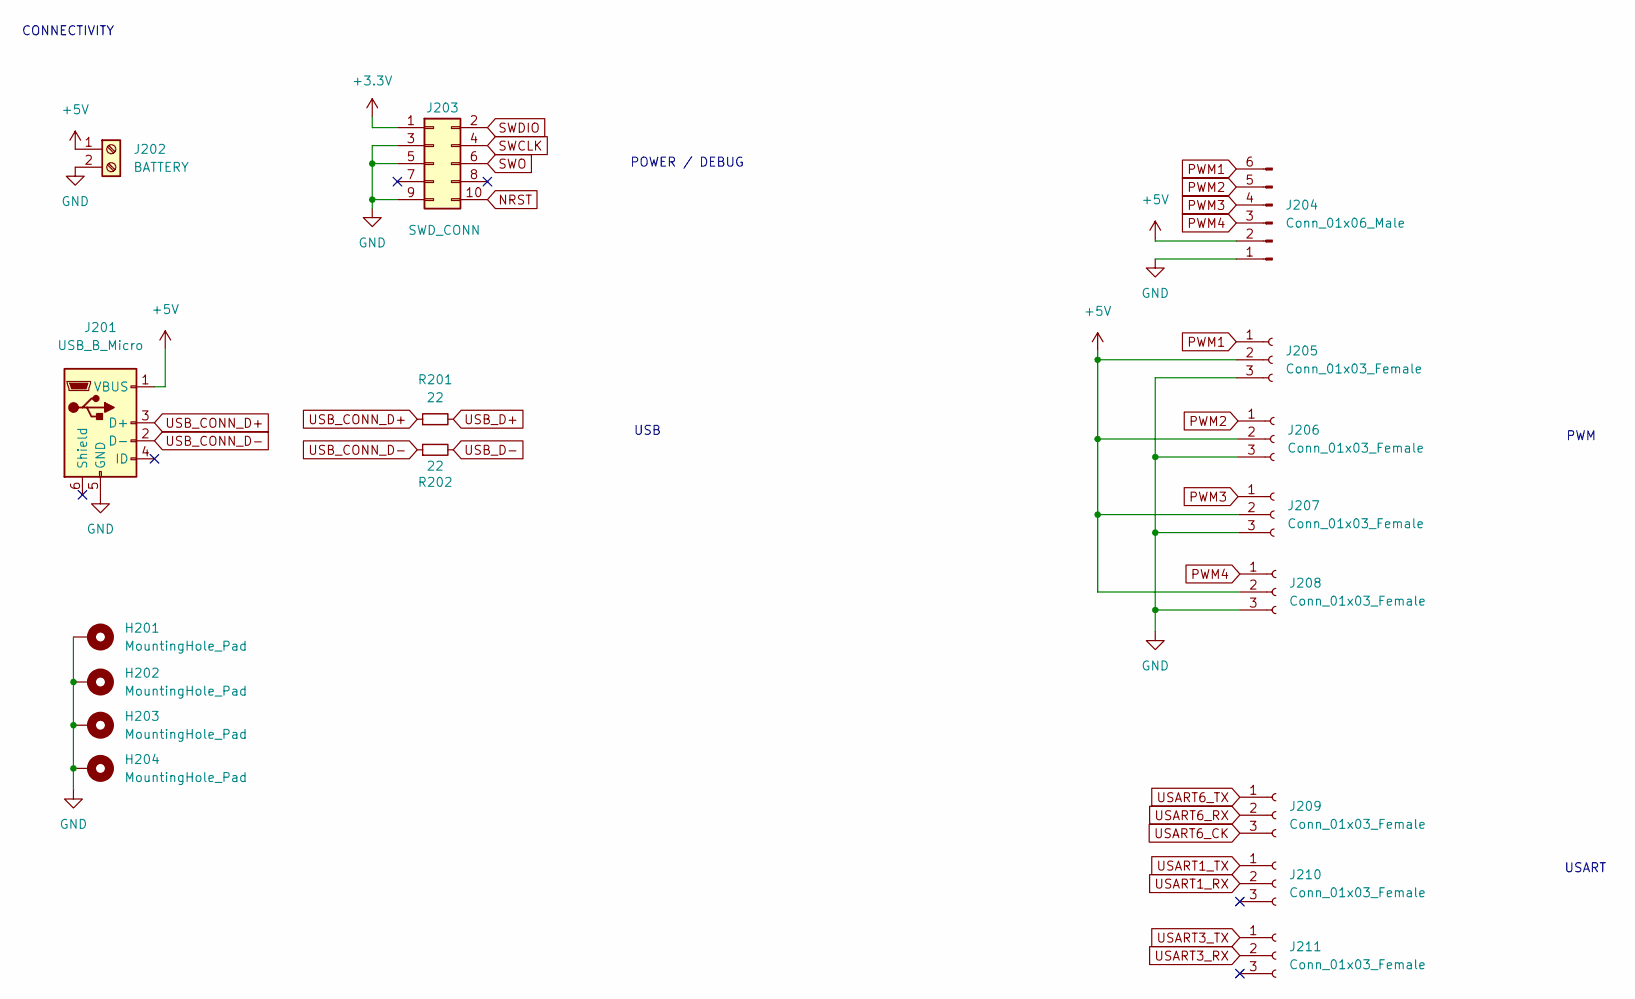
[picture p33: schematic Connectivity.kicad_sch]

Parts:
H201, H202, H203, H204: MountingHole_Pad; MountingHole_3.2mm_M3
J201: USB_B_Micro; USB_Micro-B_Molex-105017-0001
J202: BATTERY; PinHeader_1x02_P1.00mm_Vertical
J203: SWD_CONN; PinHeader_2x05_P1.27mm_Vertical_SMD
J204: Conn_01x06_Male; Hirose_DF52-6S-0.8H_1x06-1MP_P0.80mm_Horizontal
J205, J206, J207, J208, J209, J210, J211: Conn_01x03_Female; PinHeader_1x03_P1.00mm_Vertical
R201, R202: 22; R_0402_1005Metric; LCSC Part # C25092

Connections:
+5V: J201.1 (VBUS), J202.1, J204.2, J205.2, J206.2, J207.2, J208.2; also elsewhere on the board
BUCK_VOUT_3V3: J203.1; also elsewhere on the board
GND: H201.1, H202.1, H203.1, H204.1, J201.5 (GND), J202.2, J203.3, J203.5, J203.9, J204.1, J205.3, J206.3, J207.3, J208.3; also elsewhere on the board
NRST: J203.10; also elsewhere on the board
PWM1: J204.6, J205.1; also elsewhere on the board
PWM2: J204.5, J206.1; also elsewhere on the board
PWM3: J204.4, J207.1; also elsewhere on the board
PWM4: J204.3, J208.1; also elsewhere on the board
SWCLK: J203.4; also elsewhere on the board
SWDIO: J203.2; also elsewhere on the board
SWO: J203.6; also elsewhere on the board
USART1_RX: J210.2; also elsewhere on the board
USART1_TX: J210.1; also elsewhere on the board
USART3_RX: J211.2; also elsewhere on the board
USART3_TX: J211.1; also elsewhere on the board
USART6_CK: J209.3; also elsewhere on the board
USART6_RX: J209.2; also elsewhere on the board
USART6_TX: J209.1; also elsewhere on the board
USB_CONN_D+: J201.3 (D+), R201.1
USB_CONN_D-: J201.2 (D-), R202.1
USB_D+: R201.2; also elsewhere on the board
USB_D-: R202.2; also elsewhere on the board

Notes on the sheet:
POWER / DEBUG
USB
USART
PWM
CONNECTIVITY

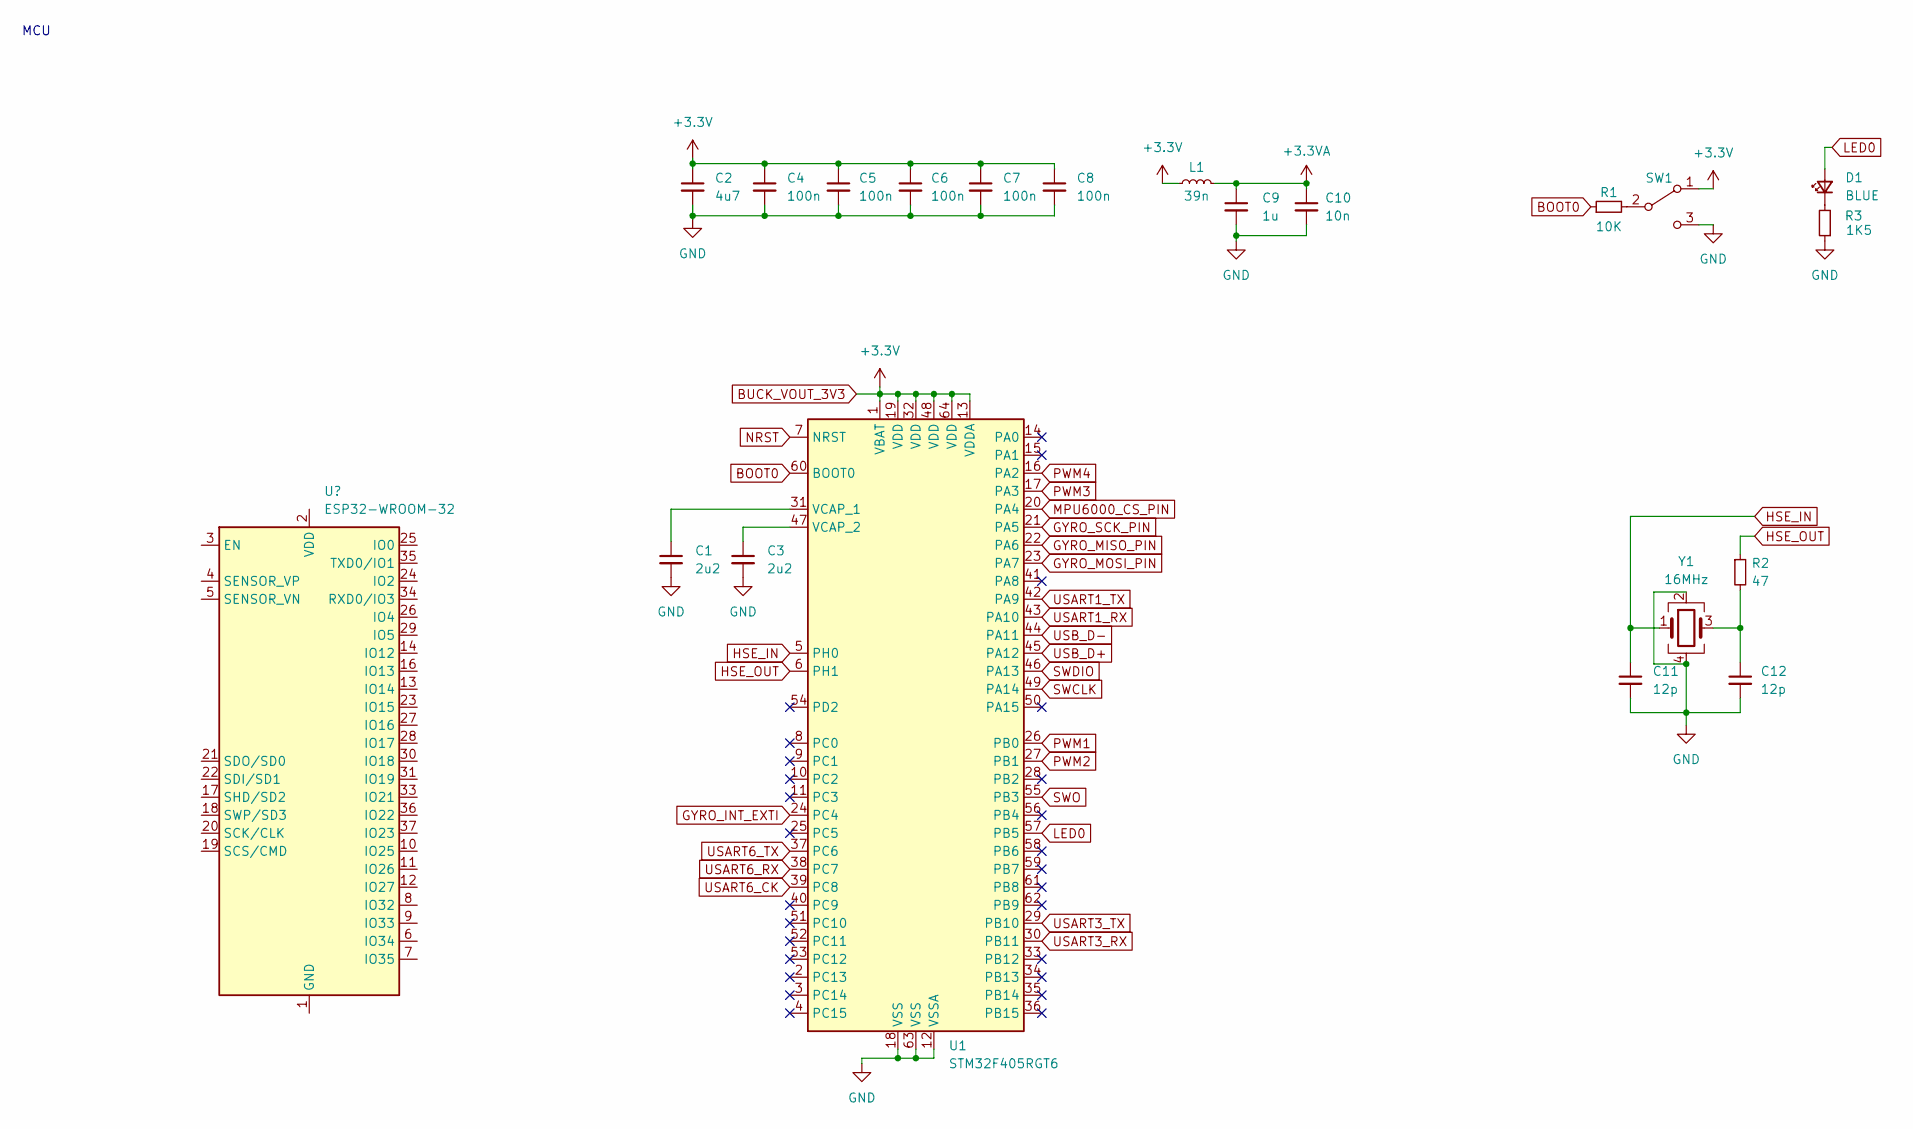
[picture p34: schematic MCU.kicad_sch]

Parts:
C1, C3: 2u2; C_0603_1608Metric; LCSC Part # C23630
C2: 4u7; C_0603_1608Metric; LCSC Part # C19666
C4, C5, C6, C7, C8: 100n; C_0402_1005Metric; LCSC Part # C307331
C9: 1u; C_0402_1005Metric; LCSC Part # C52923
C10: 10n; C_0402_1005Metric; LCSC Part # C15195
C11, C12: 12p; C_0402_1005Metric; LCSC Part # C1547
D1: BLUE; LED_0603_1608Metric; LCSC Part # C72041
L1: 39n; L_0402_1005Metric; LCSC Part # C26443
R1: 10K; R_0402_1005Metric; LCSC Part # C25744
R2: 47; R_0402_1005Metric; LCSC Part # C25792
R3: 1K5; R_0603_1608Metric; LCSC Part # C22843
SW1: SW_SPDT; SW_SPST_B3U-1000P
U1: STM32F405RGT6; LQFP-64_10x10mm_P0.5mm; LCSC Part # C15742
Y1: 16MHz; Crystal_SMD_3225-4Pin_3.2x2.5mm; LCSC Part # C13738

Connections:
+3.3VA: C9.1, C10.1, L1.2
BOOT0: R1.1, U1.60 (BOOT0)
BUCK_VOUT_3V3: C2.1, C4.1, C5.1, C6.1, C7.1, C8.1, L1.1, SW1.1 (A), U1.1 (VBAT), U1.13 (VDDA), U1.19 (VDD), U1.32 (VDD), U1.48 (VDD), U1.64 (VDD); also elsewhere on the board
GND: C1.2, C2.2, C3.2, C4.2, C5.2, C6.2, C7.2, C8.2, C9.2, C10.2, C11.2, C12.2, R3.1, SW1.3 (C), U1.12 (VSSA), U1.18 (VSS), U1.63 (VSS), Y1.2, Y1.4; also elsewhere on the board
GYRO_INT_EXTI: U1.24 (PC4); also elsewhere on the board
GYRO_MISO_PIN: U1.22 (PA6); also elsewhere on the board
GYRO_MOSI_PIN: U1.23 (PA7); also elsewhere on the board
GYRO_SCK_PIN: U1.21 (PA5); also elsewhere on the board
HSE_IN: C11.1, U1.5 (PH0), Y1.1
HSE_OUT: R2.1, U1.6 (PH1)
LED0: D1.2 (A), U1.57 (PB5)
MPU6000_CS_PIN: U1.20 (PA4); also elsewhere on the board
NRST: U1.7 (NRST); also elsewhere on the board
unnamed: C1.1, U1.31 (VCAP_1)
unnamed: C3.1, U1.47 (VCAP_2)
unnamed: C12.1, R2.2, Y1.3
unnamed: D1.1 (K), R3.2
unnamed: R1.2, SW1.2 (B)
PWM1: U1.26 (PB0); also elsewhere on the board
PWM2: U1.27 (PB1); also elsewhere on the board
PWM3: U1.17 (PA3); also elsewhere on the board
PWM4: U1.16 (PA2); also elsewhere on the board
SWCLK: U1.49 (PA14); also elsewhere on the board
SWDIO: U1.46 (PA13); also elsewhere on the board
SWO: U1.55 (PB3); also elsewhere on the board
USART1_RX: U1.43 (PA10); also elsewhere on the board
USART1_TX: U1.42 (PA9); also elsewhere on the board
USART3_RX: U1.30 (PB11); also elsewhere on the board
USART3_TX: U1.29 (PB10); also elsewhere on the board
USART6_CK: U1.39 (PC8); also elsewhere on the board
USART6_RX: U1.38 (PC7); also elsewhere on the board
USART6_TX: U1.37 (PC6); also elsewhere on the board
USB_D+: U1.45 (PA12); also elsewhere on the board
USB_D-: U1.44 (PA11); also elsewhere on the board

Notes on the sheet:
MCU

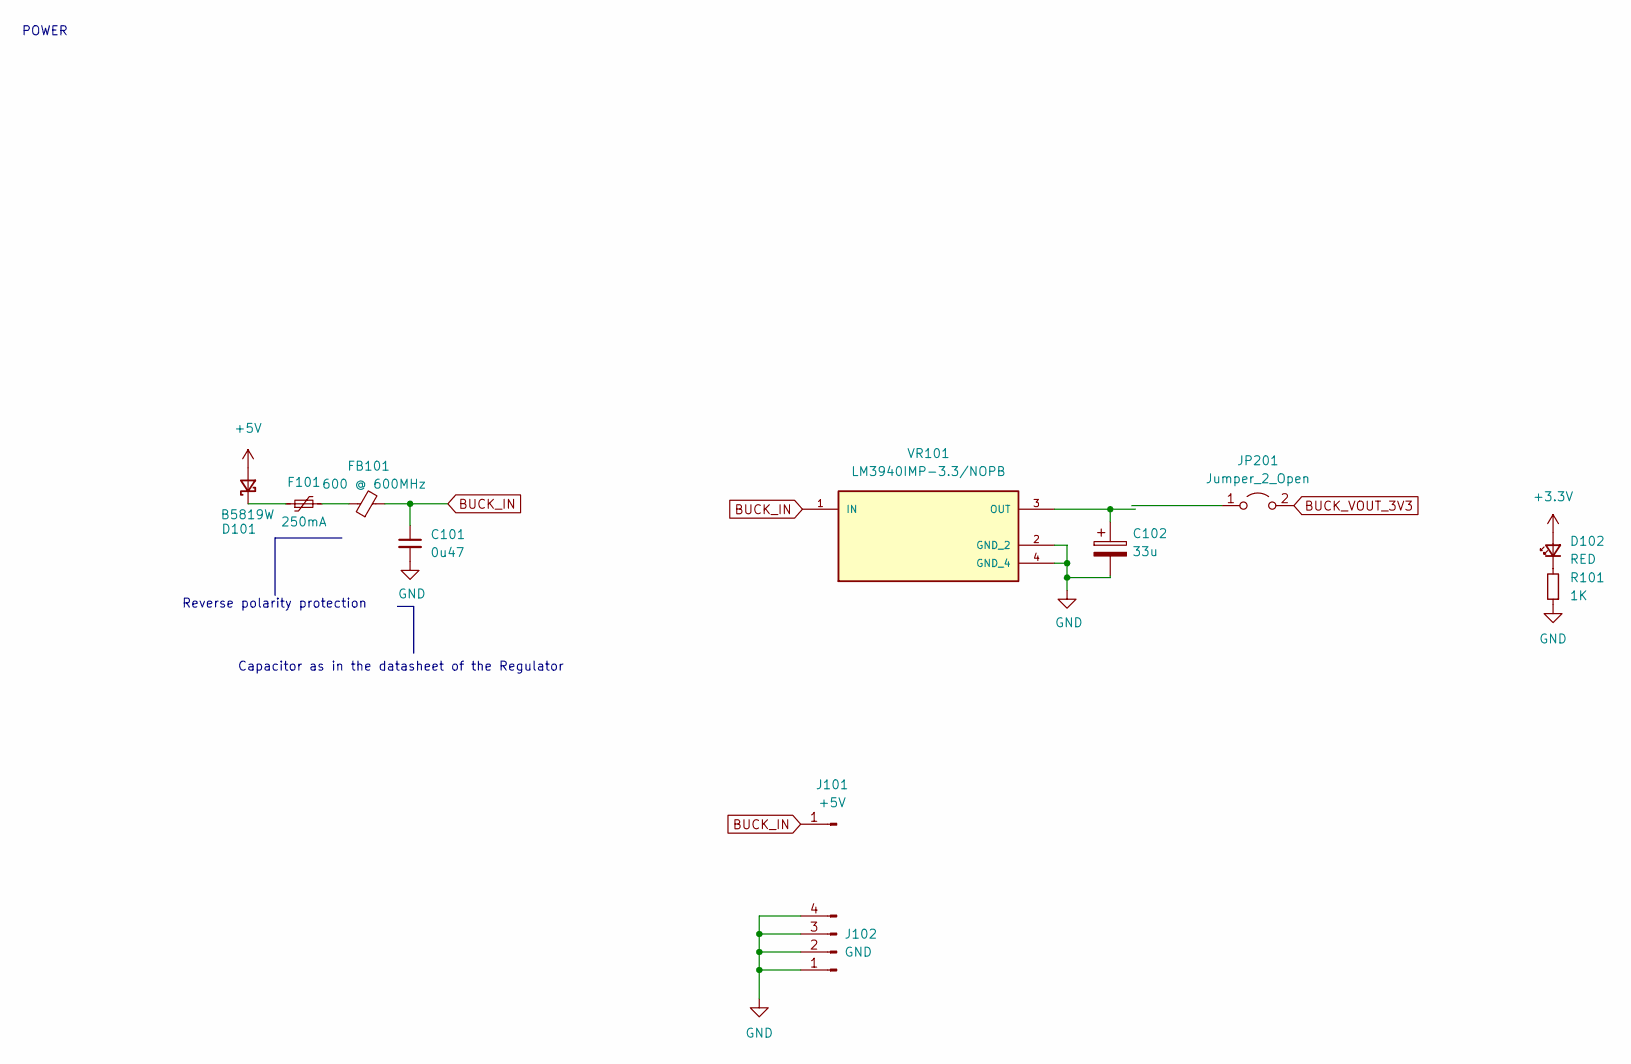
[picture p35: schematic Power.kicad_sch]

Parts:
C101: 0u47; C_1206_3216Metric; LCSC Part # C13585
C102: 33u; CP_EIA-1608-08_AVX-J; LCSC Part # C347532
D101: B5819W; D_SOD-123; LCSC Part # C8598
D102: RED; LED_0603_1608Metric; LCSC Part # C2286
F101: 250mA; Fuse_0603_1608Metric; LCSC Part # C151137
FB101: 600 @ 600MHz; L_0805_2012Metric; LCSC Part # C1017
J101: +5V; PinHeader_1x01_P1.00mm_Vertical
J102: GND; PinHeader_1x04_P1.00mm_Vertical
JP201: Jumper_2_Open; SolderJumper-2_P1.3mm_Open_RoundedPad1.0x1.5mm
R101: 1K; R_0603_1608Metric; LCSC Part # C21190
VR101: LM3940IMP-3.3/NOPB; SOT-223; PARTREV G; LCSC Part # C140319

Connections:
+5V: D101.2 (A); also elsewhere on the board
BUCK_IN: C101.1, FB101.2, J101.1, VR101.1 (IN)
BUCK_VOUT_3V3: D102.2 (A), JP201.2 (B); also elsewhere on the board
GND: C101.2, C102.2, J102.1, J102.2, J102.3, J102.4, R101.1, VR101.2 (GND_2), VR101.4 (GND_4); also elsewhere on the board
unnamed: C102.1, VR101.3 (OUT)
unnamed: D101.1 (K), F101.1
unnamed: D102.1 (K), R101.2
unnamed: F101.2, FB101.1

Notes on the sheet:
Reverse polarity protection
POWER
Capacitor as in the datasheet of the Regulator

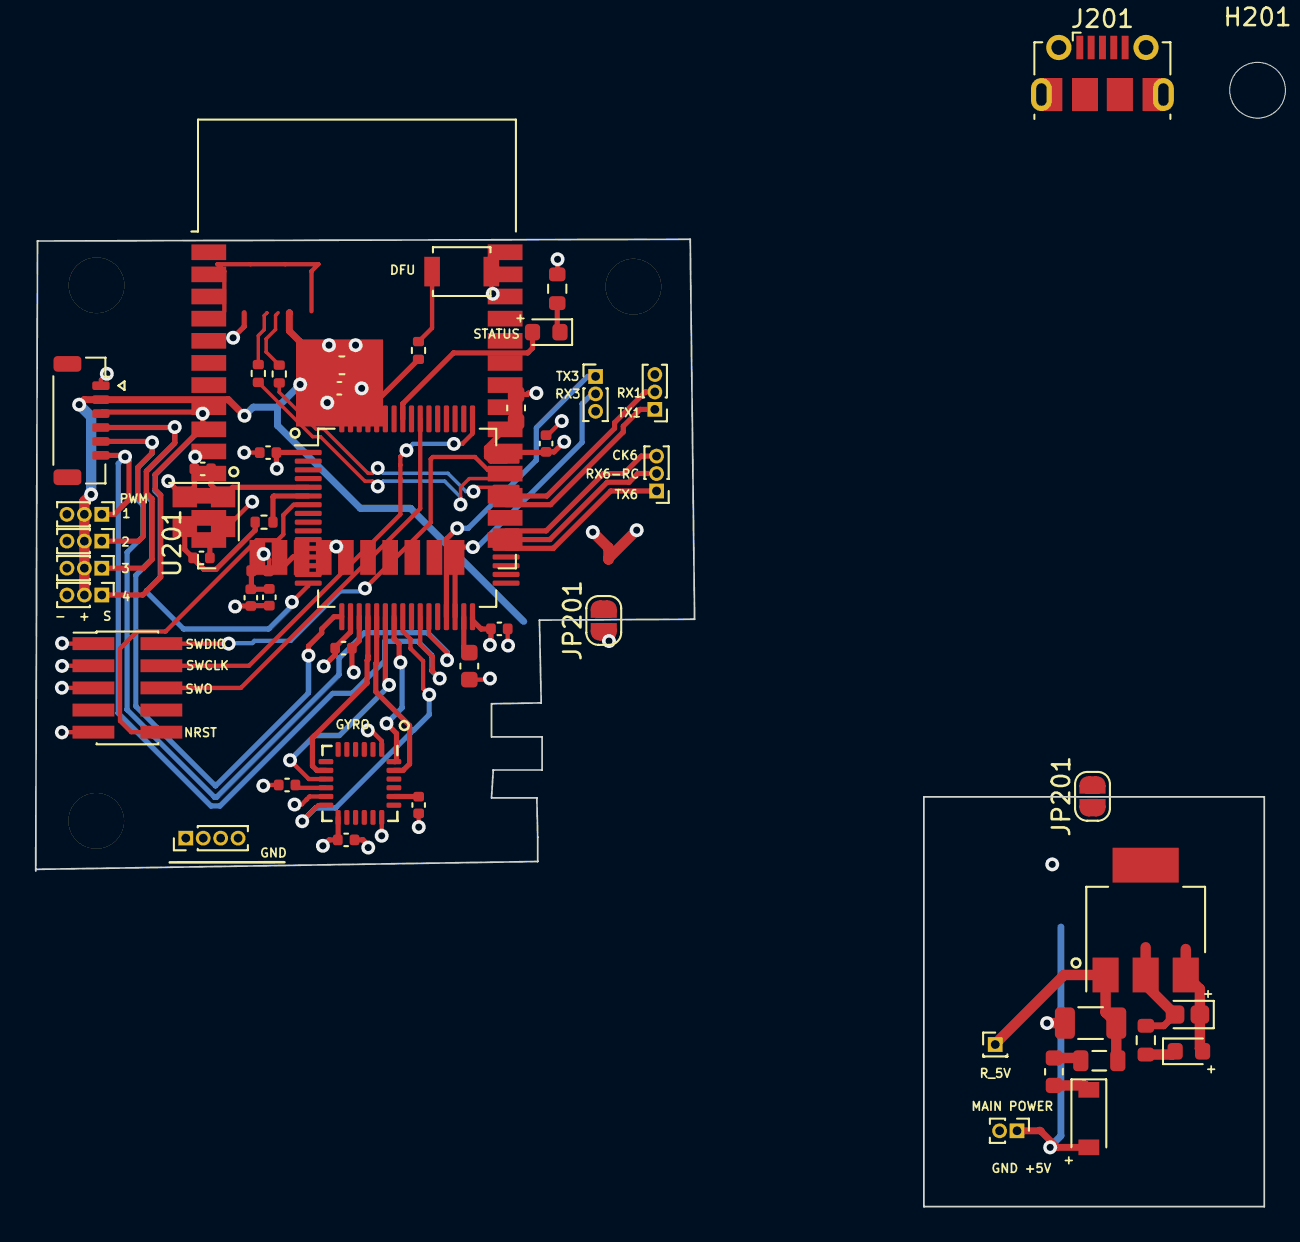
[picture p36: board DronePCB/TestConNicola/DroneHardware.kicad_pcb from above]

Board: 4 copper layers, 70.5 x 55.5 mm, 54 parts (0 on the bottom side), 45 nets.

Other parts of the board:
JP201#2: Jumper_2_Open; SolderJumper-2_P1.3mm_Open_RoundedPad1.0x1.5mm
U201: ESP32-WROOM-32

Their connections:
unnamed: U201.1 (GND), U201.15 (GND), U201.38 (GND), U201.39 (GND)
