GiovanniRaseraF/DroneTheory/DronePCB/DroneHardware/DroneHardware.kicad_pcb

## KiCad design DronePCB/DroneHardware/DroneHardware.kicad_pcb (2022-07-10, an earlier design)

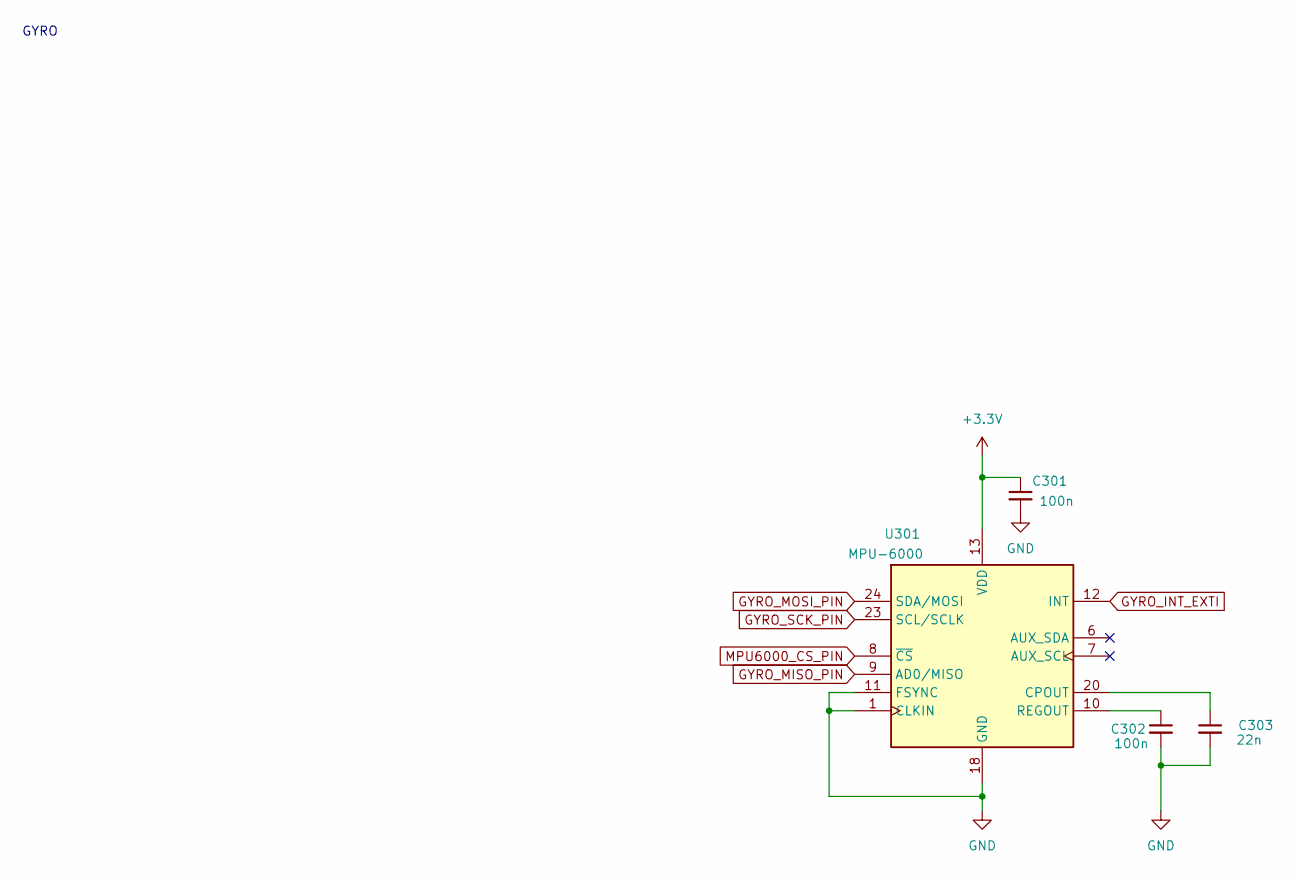
[picture p37: schematic Gyro.kicad_sch]

Parts:
C301, C302: 100n; C_0402_1005Metric; LCSC Part # C15195
C303: 22n; C_0402_1005Metric; LCSC Part # C15195
U301: MPU-6000; InvenSense_QFN-24_4x4mm_P0.5mm

Connections:
BUCK_VOUT_3V3: C301.1, U301.13 (VDD); also elsewhere on the board
GND: C301.2, C302.2, C303.2, U301.1 (CLKIN), U301.11 (FSYNC), U301.18 (GND); also elsewhere on the board
GYRO_INT_EXTI: U301.12 (INT); also elsewhere on the board
GYRO_MISO_PIN: U301.9 (AD0/MISO); also elsewhere on the board
GYRO_MOSI_PIN: U301.24 (SDA/MOSI); also elsewhere on the board
GYRO_SCK_PIN: U301.23 (SCL/SCLK); also elsewhere on the board
MPU6000_CS_PIN: U301.8 (~CS); also elsewhere on the board
unnamed: C302.1, U301.10 (REGOUT)
unnamed: C303.1, U301.20 (CPOUT)

Notes on the sheet:
GYRO

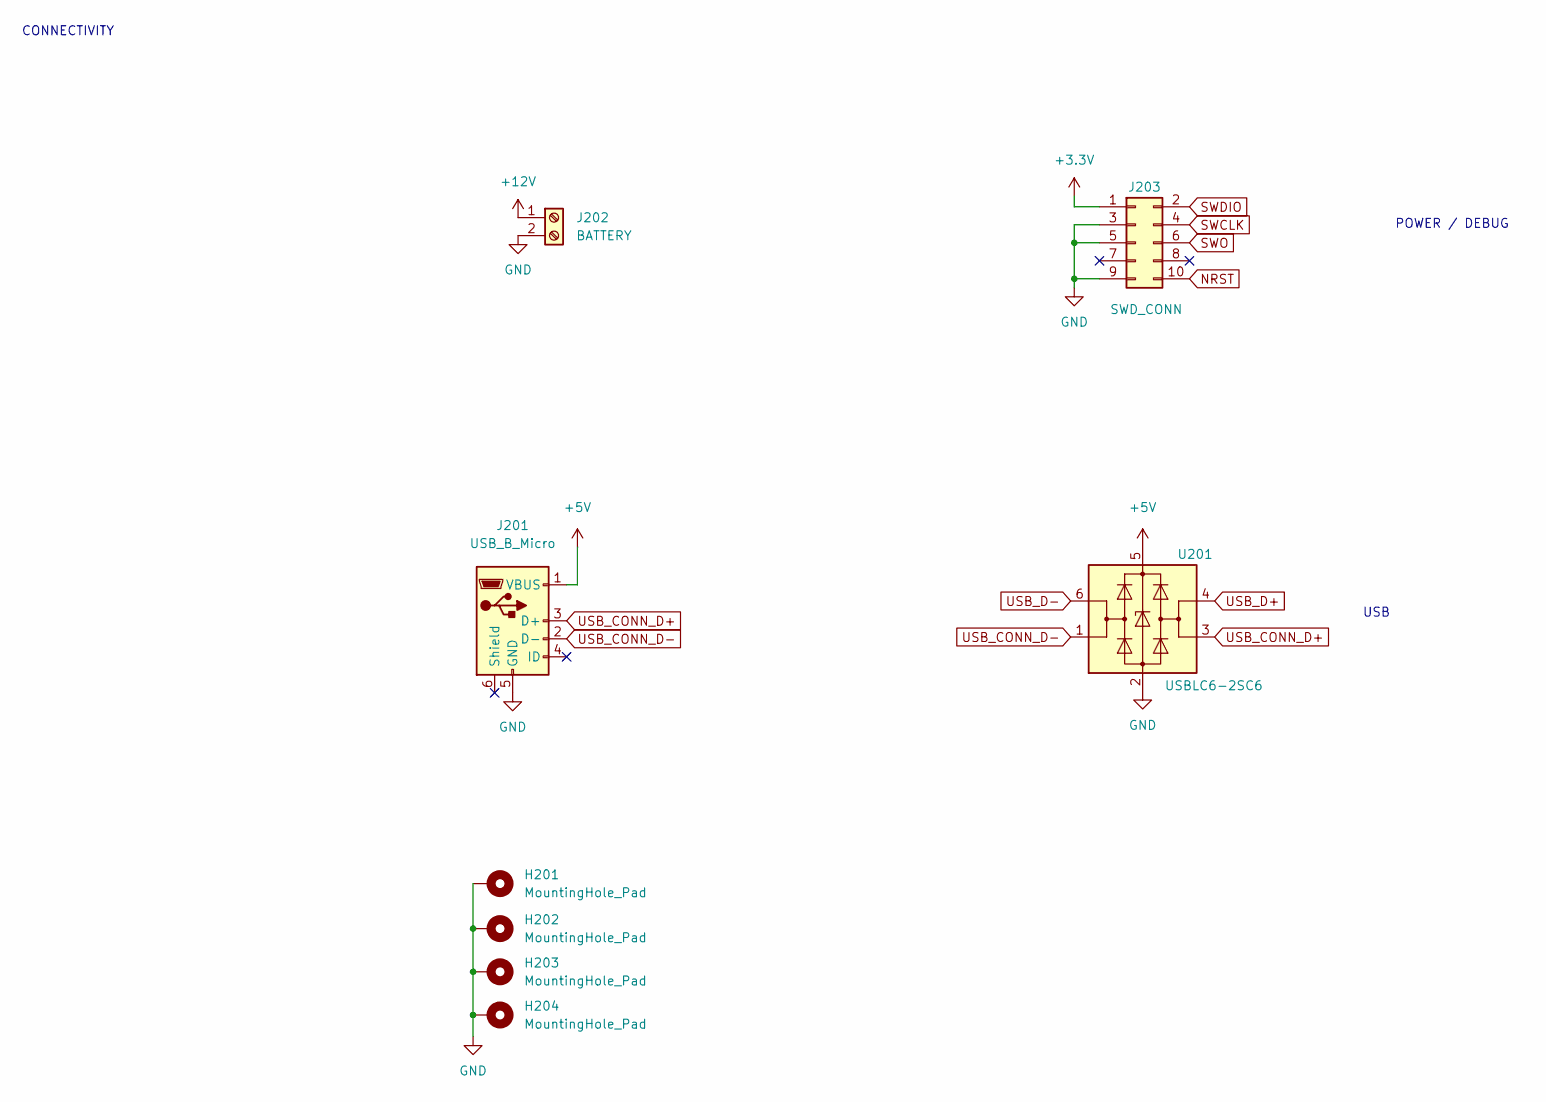
[picture p38: schematic Connectivity.kicad_sch]

Parts:
H201, H202, H203, H204: MountingHole_Pad; MountingHole_3.2mm_M3
J201: USB_B_Micro; USB_Micro-B_Molex-105017-0001
J202: BATTERY; PinHeader_1x02_P1.00mm_Vertical
J203: SWD_CONN; PinHeader_2x05_P1.27mm_Vertical_SMD
U201: USBLC6-2SC6; SOT-23-6; LCSC Part # C2827654

Connections:
+5V: J201.1 (VBUS), U201.5 (VBUS); also elsewhere on the board
+12V: J202.1; also elsewhere on the board
BUCK_VOUT_3V3: J203.1; also elsewhere on the board
GND: H201.1, H202.1, H203.1, H204.1, J201.5 (GND), J202.2, J203.3, J203.5, J203.9, U201.2 (GND); also elsewhere on the board
NRST: J203.10; also elsewhere on the board
SWCLK: J203.4; also elsewhere on the board
SWDIO: J203.2; also elsewhere on the board
SWO: J203.6; also elsewhere on the board
USB_CONN_D+: J201.3 (D+), U201.3 (I/O2)
USB_CONN_D-: J201.2 (D-), U201.1 (I/O1)
USB_D+: U201.4 (I/O2); also elsewhere on the board
USB_D-: U201.6 (I/O1); also elsewhere on the board

Notes on the sheet:
POWER / DEBUG
USB
CONNECTIVITY

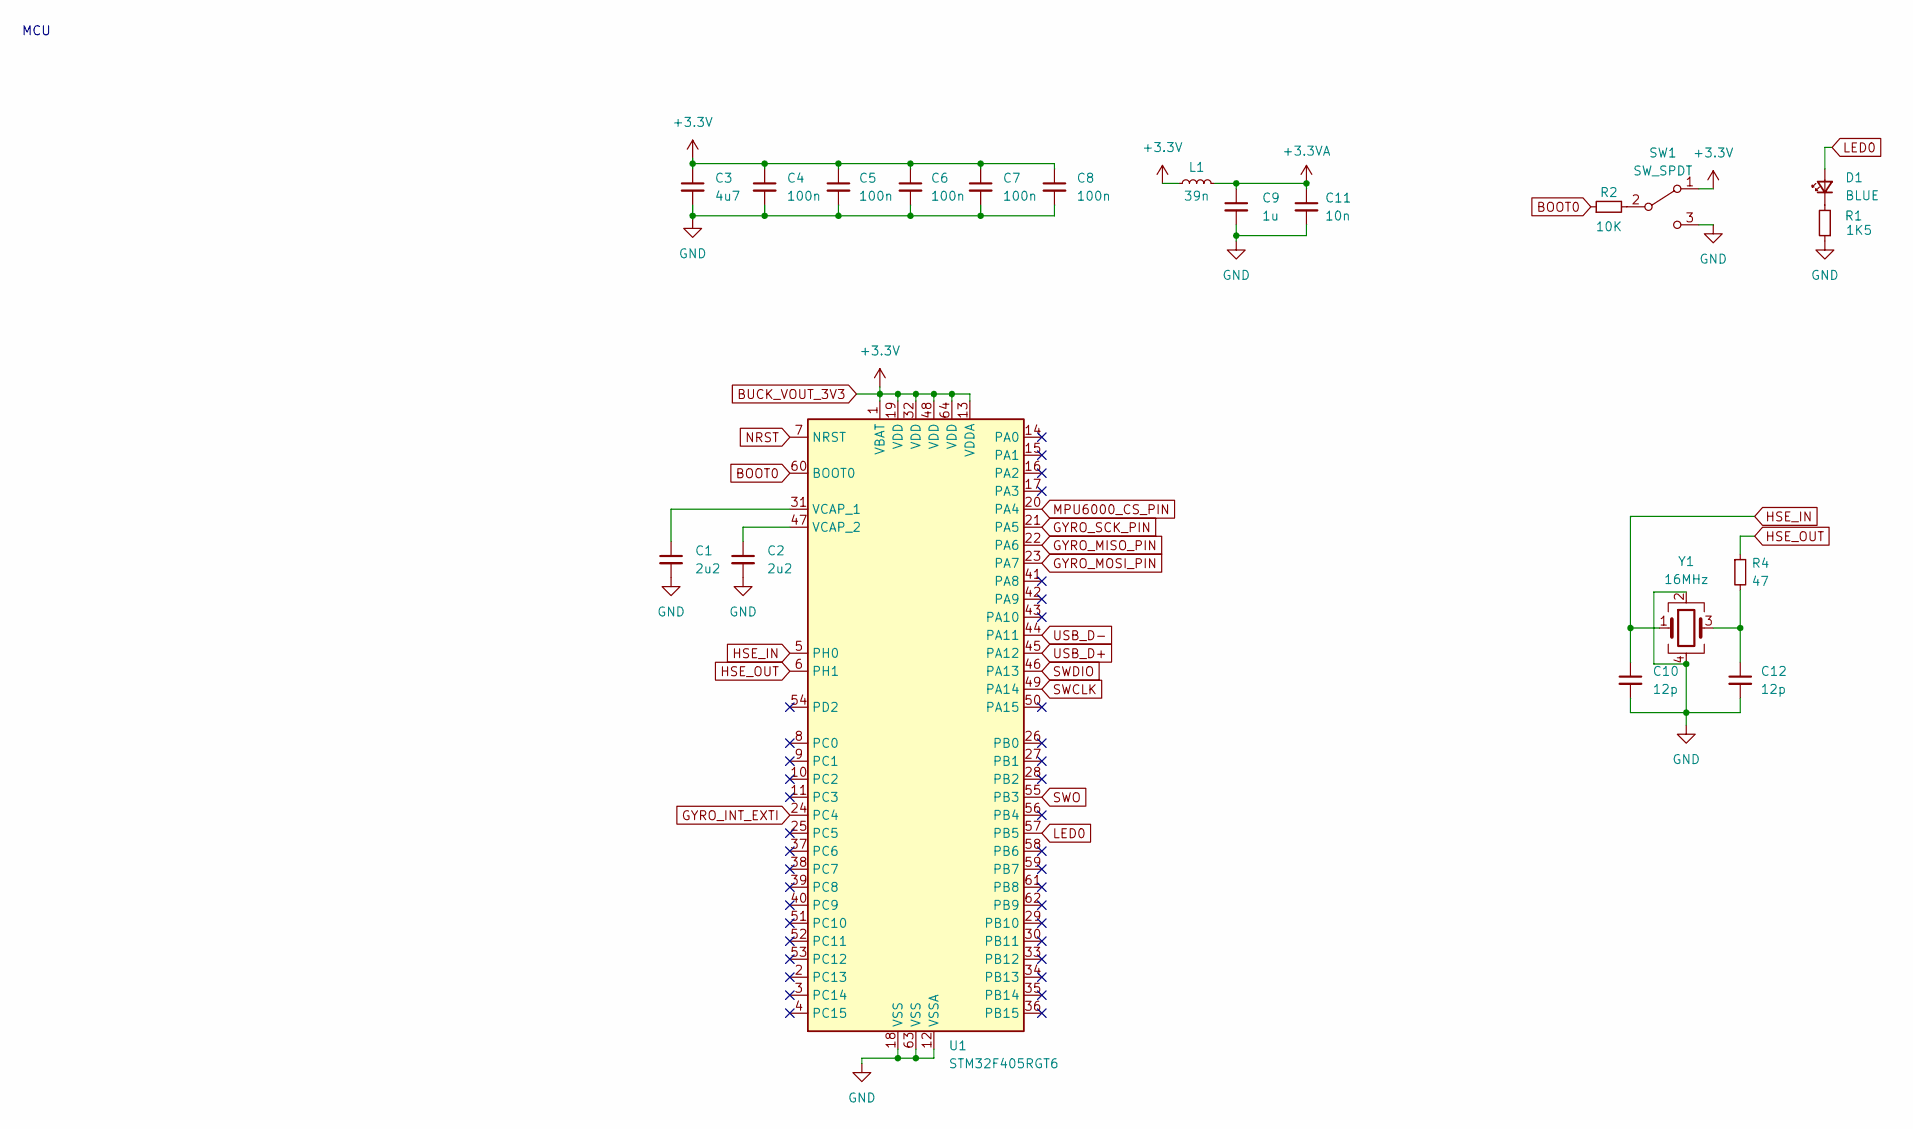
[picture p39: schematic MCU.kicad_sch]

Parts:
C1, C2: 2u2; C_0603_1608Metric; LCSC Part # C23630
C3: 4u7; C_0603_1608Metric; LCSC Part # C19666
C4, C5, C6, C7, C8: 100n; C_0402_1005Metric; LCSC Part # C307331
C9: 1u; C_0402_1005Metric; LCSC Part # C52923
C10, C12: 12p; C_0402_1005Metric; LCSC Part # C1547
C11: 10n; C_0402_1005Metric; LCSC Part # C15195
D1: BLUE; LED_0603_1608Metric; LCSC Part # C72041
L1: 39n; L_0402_1005Metric; LCSC Part # C26443
R1: 1K5; R_0603_1608Metric; LCSC Part # C22843
R2: 10K; R_0402_1005Metric; LCSC Part # C25744
R4: 47; R_0402_1005Metric; LCSC Part # C25792
SW1: SW_SPDT; SW_SPDT_PCM12
U1: STM32F405RGT6; LQFP-64_10x10mm_P0.5mm
Y1: 16MHz; Crystal_SMD_3225-4Pin_3.2x2.5mm; LCSC Part # C13738

Connections:
+3.3VA: C9.1, C11.1, L1.2
BOOT0: R2.1, U1.60 (BOOT0)
BUCK_VOUT_3V3: C3.1, C4.1, C5.1, C6.1, C7.1, C8.1, L1.1, SW1.1 (A), U1.1 (VBAT), U1.13 (VDDA), U1.19 (VDD), U1.32 (VDD), U1.48 (VDD), U1.64 (VDD); also elsewhere on the board
GND: C1.2, C2.2, C3.2, C4.2, C5.2, C6.2, C7.2, C8.2, C9.2, C10.2, C11.2, C12.2, R1.1, SW1.3 (C), U1.12 (VSSA), U1.18 (VSS), U1.63 (VSS), Y1.2, Y1.4; also elsewhere on the board
GYRO_INT_EXTI: U1.24 (PC4); also elsewhere on the board
GYRO_MISO_PIN: U1.22 (PA6); also elsewhere on the board
GYRO_MOSI_PIN: U1.23 (PA7); also elsewhere on the board
GYRO_SCK_PIN: U1.21 (PA5); also elsewhere on the board
HSE_IN: C10.1, U1.5 (PH0), Y1.1
HSE_OUT: R4.1, U1.6 (PH1)
LED0: D1.2 (A), U1.57 (PB5)
MPU6000_CS_PIN: U1.20 (PA4); also elsewhere on the board
NRST: U1.7 (NRST); also elsewhere on the board
unnamed: C1.1, U1.31 (VCAP_1)
unnamed: C2.1, U1.47 (VCAP_2)
unnamed: C12.1, R4.2, Y1.3
unnamed: D1.1 (K), R1.2
unnamed: R2.2, SW1.2 (B)
SWCLK: U1.49 (PA14); also elsewhere on the board
SWDIO: U1.46 (PA13); also elsewhere on the board
SWO: U1.55 (PB3); also elsewhere on the board
USB_D+: U1.45 (PA12); also elsewhere on the board
USB_D-: U1.44 (PA11); also elsewhere on the board

Notes on the sheet:
MCU

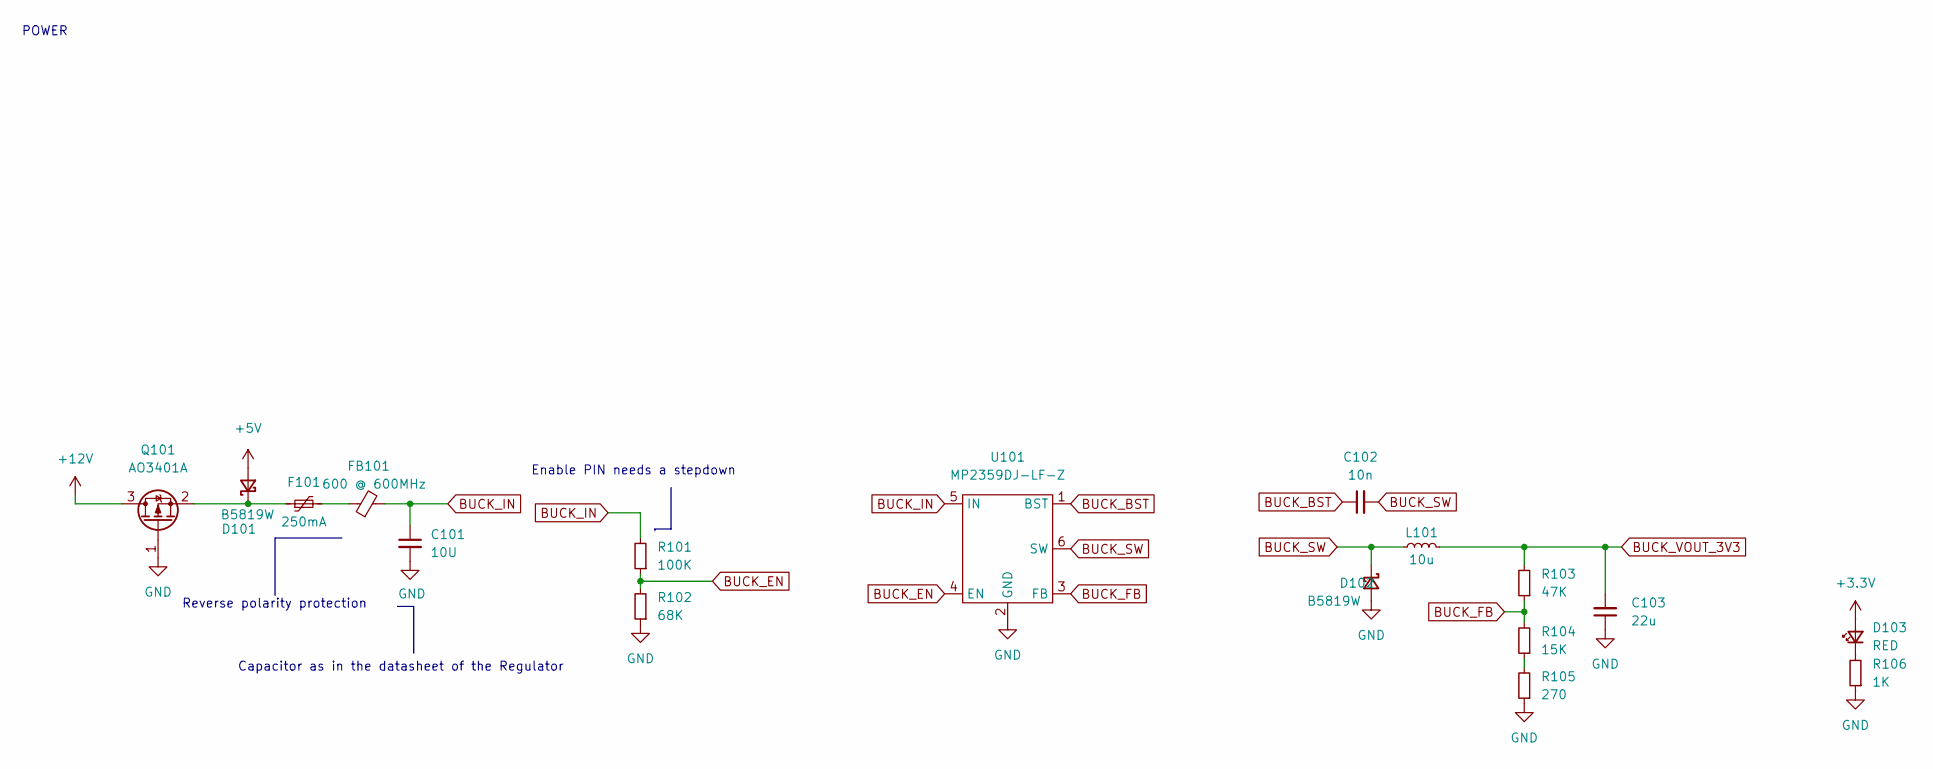
[picture p40: schematic Power.kicad_sch]

Parts:
C101: 10U; C_1206_3216Metric; LCSC Part # C13585
C102: 10n; C_0603_1608Metric; LCSC Part # C57112
C103: 22u; C_1206_3216Metric; LCSC Part # C12891
D101, D102: B5819W; D_SOD-123; LCSC Part # C8598
D103: RED; LED_0603_1608Metric; LCSC Part # C2286
F101: 250mA; Fuse_0603_1608Metric; LCSC Part # C151137
FB101: 600 @ 600MHz; L_0805_2012Metric; LCSC Part # C1017
L101: 10u; L_Sunlord_MWSA0518_5.4x5.2mm; LCSC Part # C139506
Q101: AO3401A; SOT-23; LCSC Part # C15127
R101: 100K; R_0603_1608Metric; LCSC Part # C25803
R102: 68K; R_0603_1608Metric; LCSC Part # C23231
R103: 47K; R_0603_1608Metric; LCSC Part # C25819
R104: 15K; R_0603_1608Metric; LCSC Part # C22809
R105: 270; R_0603_1608Metric; LCSC Part # C22966
R106: 1K; R_0603_1608Metric; LCSC Part # C21190
U101: MP2359DJ-LF-Z; SOT-23-6; LCSC Part # C14259

Connections:
+5V: D101.2 (A); also elsewhere on the board
+12V: Q101.3 (D); also elsewhere on the board
BUCK_BST: C102.1, U101.1 (BST)
BUCK_EN: R101.1, R102.2, U101.4 (EN)
BUCK_FB: R103.1, R104.2, U101.3 (FB)
BUCK_IN: C101.1, FB101.2, R101.2, U101.5 (IN)
BUCK_SW: C102.2, D102.1 (K), L101.1, U101.6 (SW)
BUCK_VOUT_3V3: C103.2, D103.2 (A), L101.2, R103.2; also elsewhere on the board
GND: C101.2, C103.1, D102.2 (A), Q101.1 (G), R102.1, R105.1, R106.1, U101.2 (GND); also elsewhere on the board
unnamed: D101.1 (K), F101.1, Q101.2 (S)
unnamed: D103.1 (K), R106.2
unnamed: F101.2, FB101.1
unnamed: R104.1, R105.2

Notes on the sheet:
Reverse polarity protection
POWER
Enable PIN needs a stepdown
Capacitor as in the datasheet of the Regulator

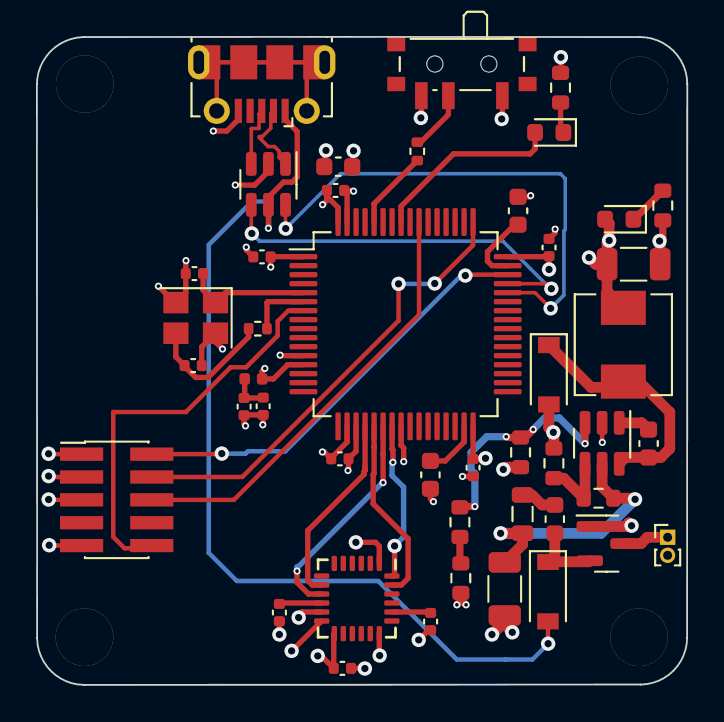
[picture p41: board DronePCB/DroneHardware/DroneHardware.kicad_pcb from above]

Board: 6 copper layers, 36.1 x 36.0 mm, 49 parts (0 on the bottom side), 38 nets.
