GiovanniRaseraF/DroneTheory/DronePCB/HWCorso/HWCorso.kicad_pcb

## KiCad design DronePCB/HWCorso/HWCorso.kicad_pcb (2022-07-05)

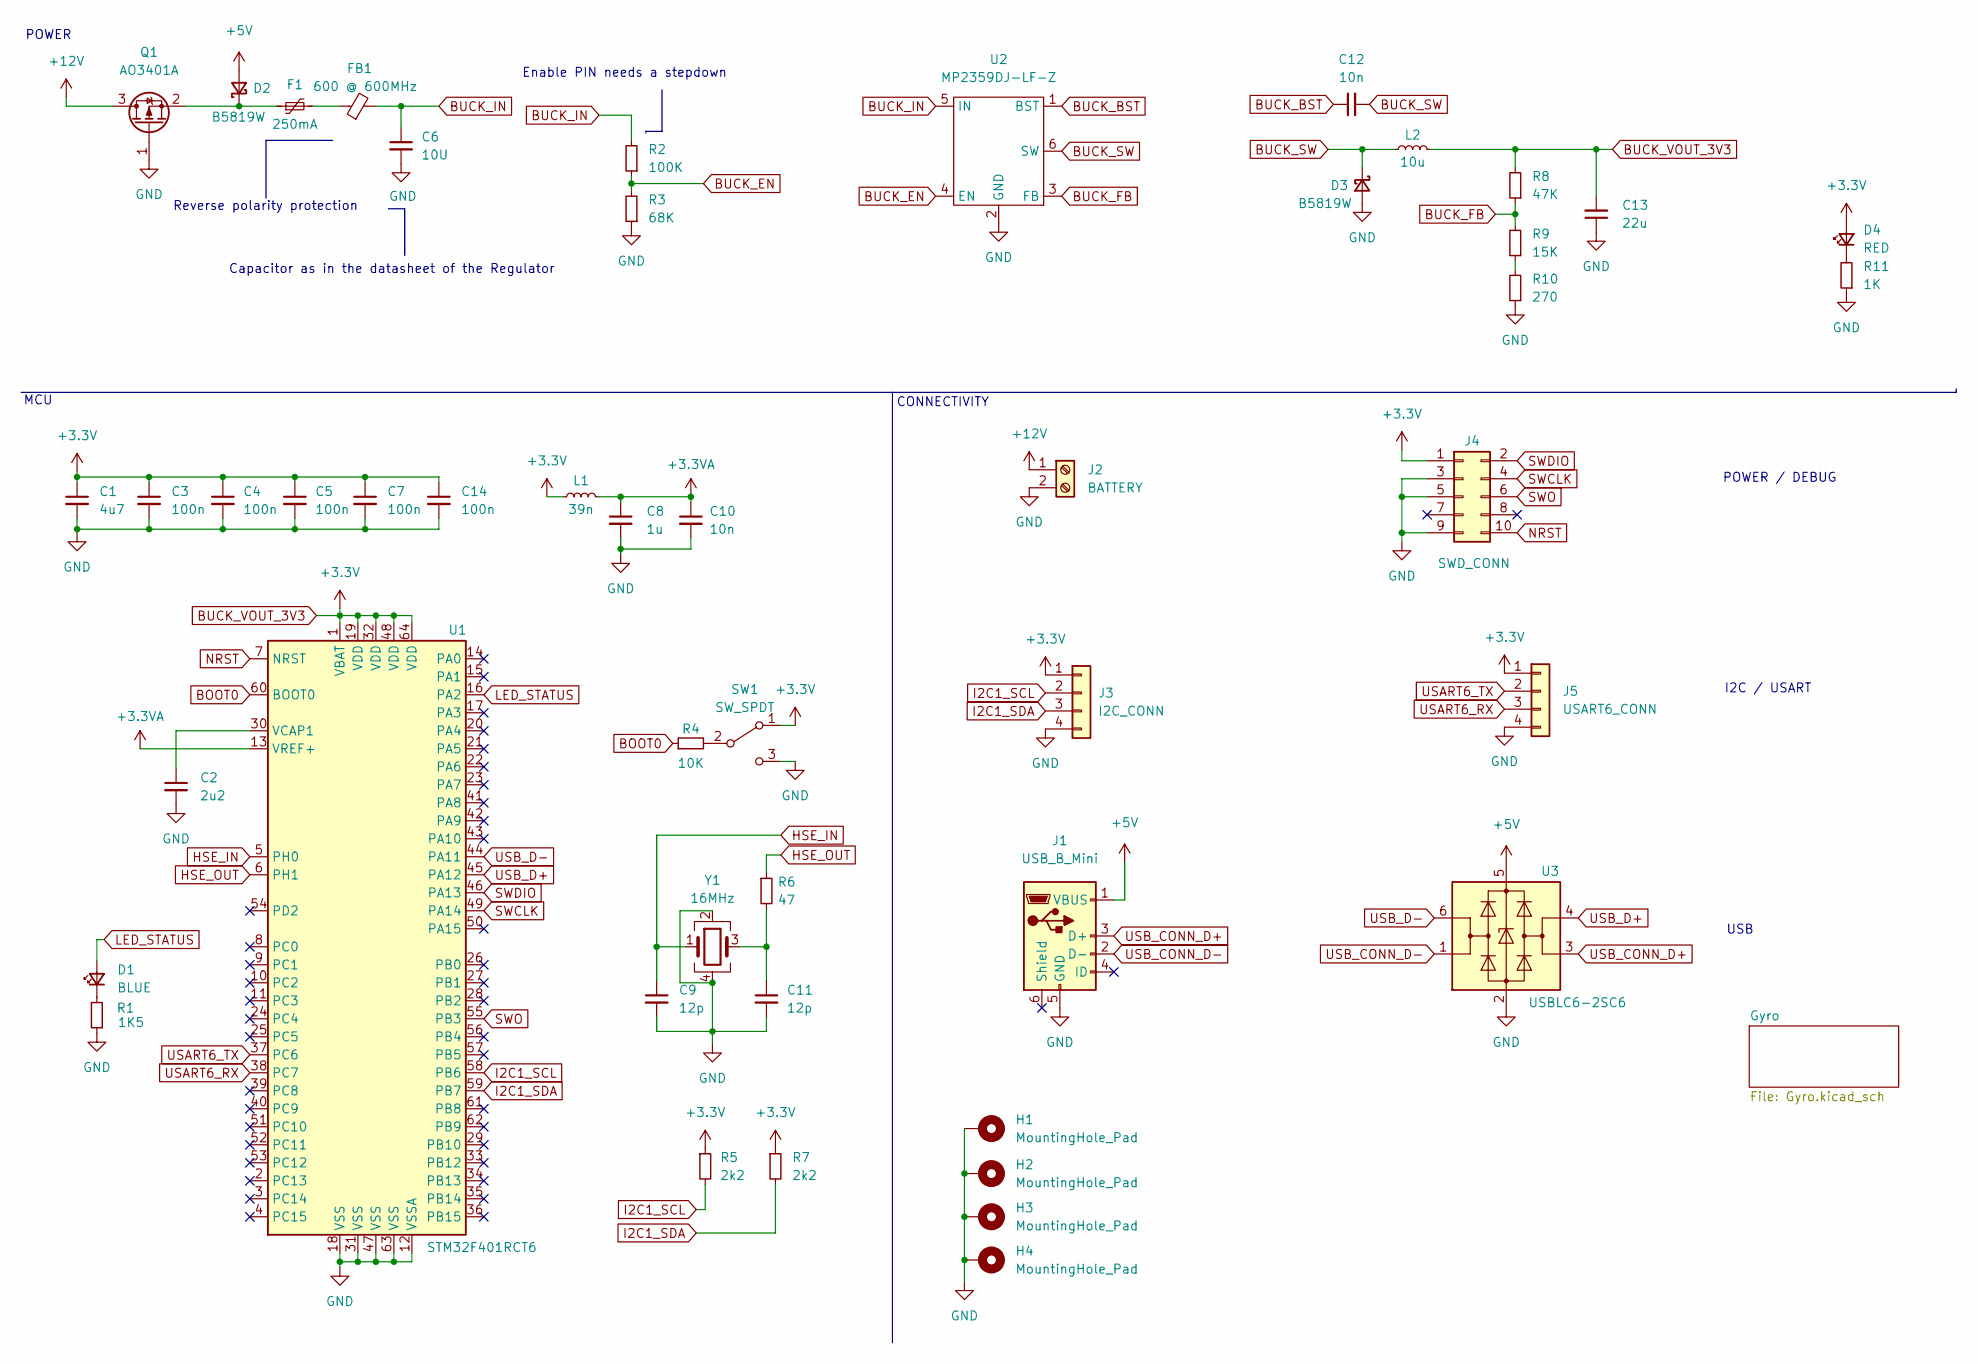
[picture p42: schematic HWCorso.kicad_sch, STM32 Corso]

Parts:
C1: 4u7; C_0603_1608Metric; LCSC Part # C19666
C2: 2u2; C_0603_1608Metric; LCSC Part # C23630
C3, C4, C5, C7, C14: 100n; C_0402_1005Metric; LCSC Part # C307331
C6: 10U; C_1206_3216Metric; LCSC Part # C13585
C8: 1u; C_0402_1005Metric; LCSC Part # C52923
C9, C11: 12p; C_0402_1005Metric; LCSC Part # C1547
C10: 10n; C_0402_1005Metric; LCSC Part # C15195
C12: 10n; C_0603_1608Metric; LCSC Part # C57112
C13: 22u; C_1206_3216Metric; LCSC Part # C12891
D1: BLUE; LED_0603_1608Metric; LCSC Part # C72041
D2, D3: B5819W; D_SOD-123; LCSC Part # C8598
D4: RED; LED_0603_1608Metric; LCSC Part # C2286
F1: 250mA; Fuse_0603_1608Metric; LCSC Part # C151137
FB1: 600 @ 600MHz; L_0805_2012Metric; LCSC Part # C1017
H1, H2, H3, H4: MountingHole_Pad; MountingHole_4.3mm_M4_Pad_Via
J1: USB_B_Mini; USB_Mini-B_Wuerth_65100516121_Horizontal
J2: BATTERY; TerminalBlock_Phoenix_PT-1,5-2-3.5-H_1x02_P3.50mm_Horizontal
J3: I2C_CONN; Molex_PicoBlade_53048-0410_1x04_P1.25mm_Horizontal
J4: SWD_CONN; PinHeader_2x05_P1.27mm_Vertical_SMD
J5: USART6_CONN; Molex_PicoBlade_53048-0410_1x04_P1.25mm_Horizontal
L1: 39n; L_0402_1005Metric; LCSC Part # C26443
L2: 10u; L_Sunlord_MWSA0518_5.4x5.2mm; LCSC Part # C139506
Q1: AO3401A; SOT-23; LCSC Part # C15127
R1: 1K5; R_0603_1608Metric; LCSC Part # C22843
R2: 100K; R_0603_1608Metric; LCSC Part # C25803
R3: 68K; R_0603_1608Metric; LCSC Part # C23231
R4: 10K; R_0402_1005Metric; LCSC Part # C25744
R5, R7: 2k2; R_0603_1608Metric; LCSC Part # C4190
R6: 47; R_0402_1005Metric; LCSC Part # C25792
R8: 47K; R_0603_1608Metric; LCSC Part # C25819
R9: 15K; R_0603_1608Metric; LCSC Part # C22809
R10: 270; R_0603_1608Metric; LCSC Part # C22966
R11: 1K; R_0603_1608Metric; LCSC Part # C21190
SW1: SW_SPDT; SW_SPDT_PCM12
U1: STM32F401RCT6; LQFP-64_10x10mm_P0.5mm; LCSC Part # C74524
U2: MP2359DJ-LF-Z; SOT-23-6; LCSC Part # C14259
U3: USBLC6-2SC6; SOT-23-6; LCSC Part # C2827654
Y1: 16MHz; Crystal_SMD_3225-4Pin_3.2x2.5mm; LCSC Part # C13738

Connections:
+3.3VA: C8.1, C10.1, L1.2, U1.13 (VREF+)
+5V: D2.2 (A), J1.1 (VBUS), U3.5 (VBUS)
+12V: J2.1, Q1.3 (D)
BOOT0: R4.1, U1.60 (BOOT0)
BUCK_BST: C12.1, U2.1 (BST)
BUCK_EN: R2.1, R3.2, U2.4 (EN)
BUCK_FB: R8.1, R9.2, U2.3 (FB)
BUCK_IN: C6.1, FB1.2, R2.2, U2.5 (IN)
BUCK_SW: C12.2, D3.1 (K), L2.1, U2.6 (SW)
BUCK_VOUT_3V3: C1.1, C3.1, C4.1, C5.1, C7.1, C13.2, C14.1, D4.2 (A), J3.1, J4.1, J5.1, L1.1, L2.2, R5.1, R7.1, R8.2, SW1.1 (A), U1.1 (VBAT), U1.19 (VDD), U1.32 (VDD), U1.48 (VDD), U1.64 (VDD)
GND: C1.2, C2.2, C3.2, C4.2, C5.2, C6.2, C7.2, C8.2, C9.2, C10.2, C11.2, C13.1, C14.2, D3.2 (A), H1.1, H2.1, H3.1, H4.1, J1.5 (GND), J2.2, J3.4, J4.3, J4.5, J4.9, J5.4, Q1.1 (G), R1.1, R3.1, R10.1, R11.1, SW1.3 (C), U1.12 (VSSA), U1.18 (VSS), U1.31 (VSS), U1.47 (VSS), U1.63 (VSS), U2.2 (GND), U3.2 (GND), Y1.2, Y1.4
HSE_IN: C9.1, U1.5 (PH0), Y1.1
HSE_OUT: R6.1, U1.6 (PH1)
I2C1_SCL: J3.2, R5.2, U1.58 (PB6)
I2C1_SDA: J3.3, R7.2, U1.59 (PB7)
LED_STATUS: D1.2 (A), U1.16 (PA2)
NRST: J4.10, U1.7 (NRST)
unnamed: C2.1, U1.30 (VCAP1)
unnamed: C11.1, R6.2, Y1.3
unnamed: D1.1 (K), R1.2
unnamed: D2.1 (K), F1.1, Q1.2 (S)
unnamed: D4.1 (K), R11.2
unnamed: F1.2, FB1.1
unnamed: R4.2, SW1.2 (B)
unnamed: R9.1, R10.2
SWCLK: J4.4, U1.49 (PA14)
SWDIO: J4.2, U1.46 (PA13)
SWO: J4.6, U1.55 (PB3)
USART6_RX: J5.3, U1.38 (PC7)
USART6_TX: J5.2, U1.37 (PC6)
USB_CONN_D+: J1.3 (D+), U3.3 (I/O2)
USB_CONN_D-: J1.2 (D-), U3.1 (I/O1)
USB_D+: U1.45 (PA12), U3.4 (I/O2)
USB_D-: U1.44 (PA11), U3.6 (I/O1)

Notes on the sheet:
USB
POWER
MCU
Capacitor as in the datasheet of the Regulator
I2C / USART
Enable PIN needs a stepdown
CONNECTIVITY
Reverse polarity protection
POWER / DEBUG

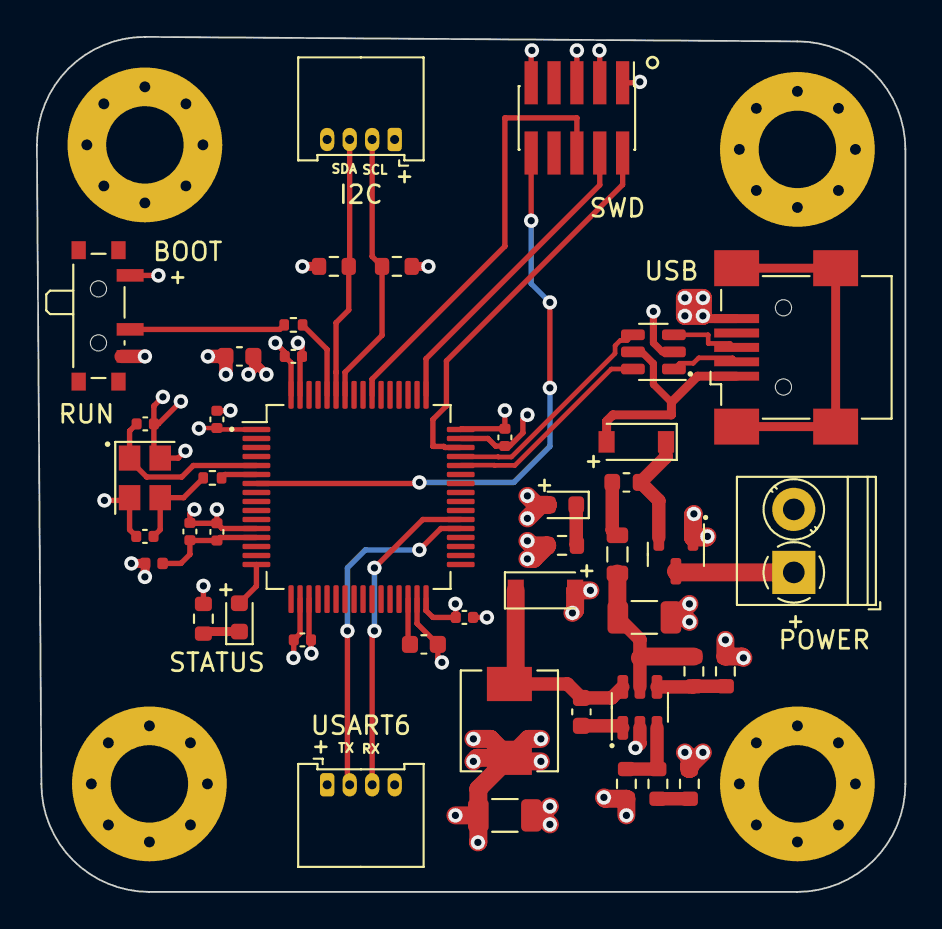
[picture p43: board HWCorso.kicad_pcb from above]

Board: 4 copper layers, 48.2 x 47.5 mm, 48 parts (0 on the bottom side), 34 nets.
