GiovanniRaseraF/DroneTheory/JeppRadiocomandataARDUINO/Hardware/JeepPCB/JeepPCB.kicad_pcb

## KiCad design JeppRadiocomandataARDUINO/Hardware/JeepPCB/JeepPCB.kicad_pcb (2022-06-28)

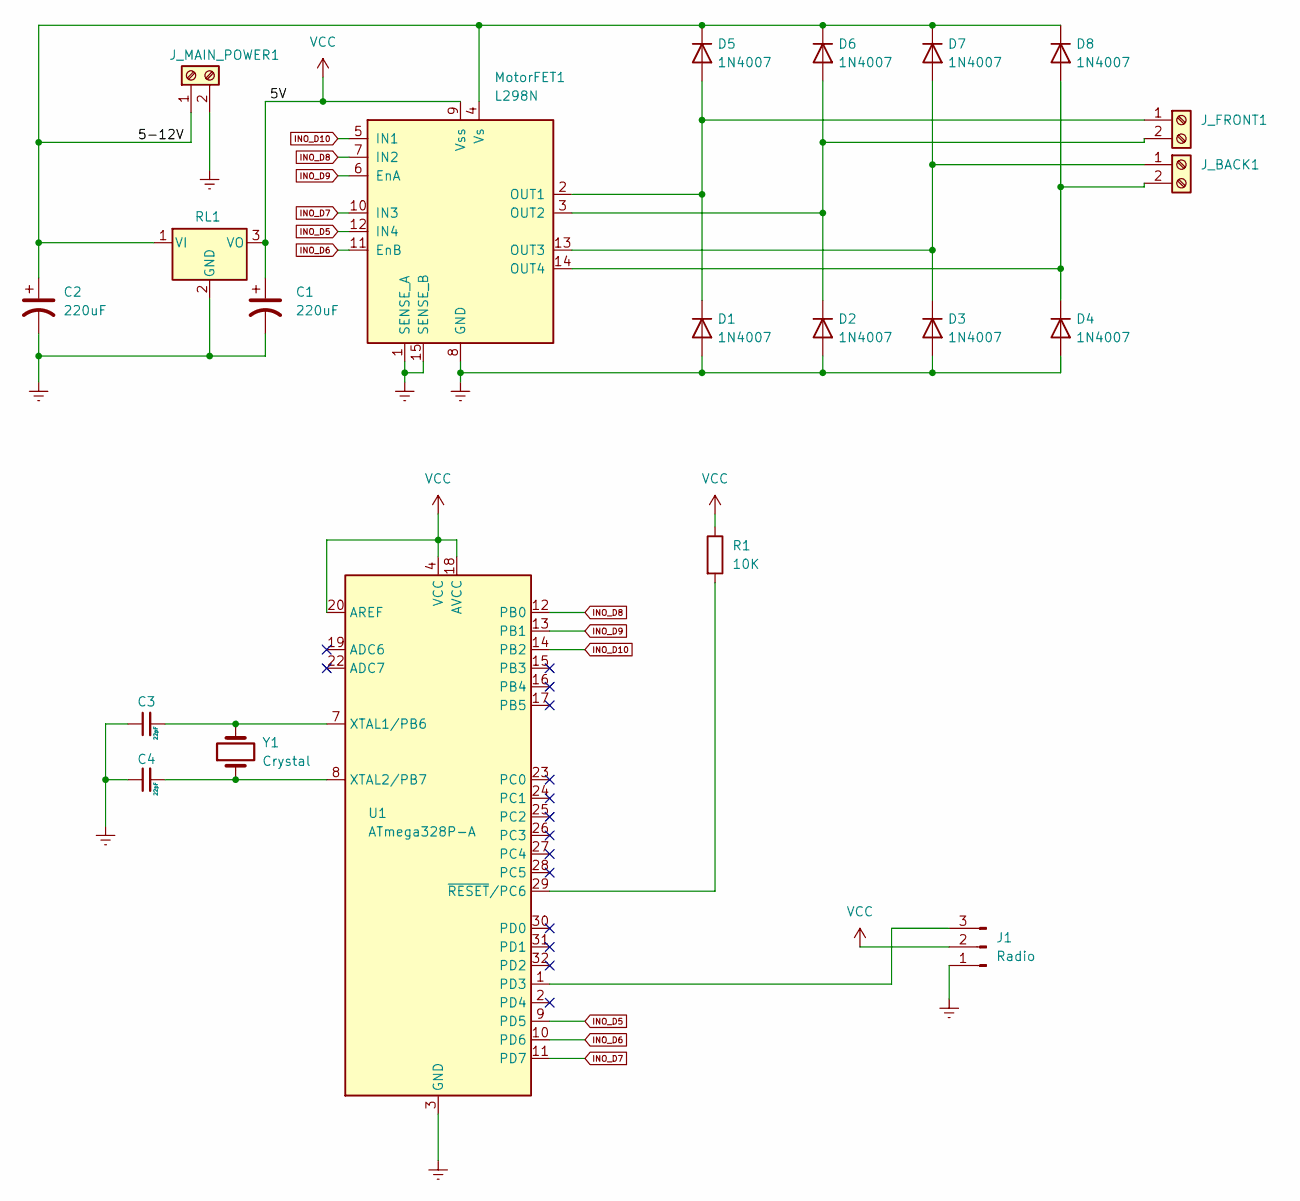
[picture p44: schematic JeepPCB.kicad_sch, Jepp Radiocomandata]

Parts:
C1, C2: 220uF; C_Elec_8x10.2
C3, C4: 22pF; CP_EIA-1608-10_AVX-L_Pad1.25x1.05mm_HandSolder
D1, D2, D3, D4, D5, D6, D7, D8: 1N4007; D_MicroMELF_Handsoldering
J1: Radio; PinHeader_1x03_P2.00mm_Vertical
J_BACK1: Screw_Terminal_01x02; TerminalBlock_Phoenix_MKDS-1,5-2-5.08_1x02_P5.08mm_Horizont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
J_FRONT1: Screw_Terminal_01x02; TerminalBlock_Phoenix_MKDS-1,5-2-5.08_1x02_P5.08mm_Horizont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
J_MAIN_POWER1: Screw_Terminal_01x02; TerminalBlock_Phoenix_MKDS-1,5-2-5.08_1x02_P5.08mm_Horizont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
MotorFET1: L298N; TO-220-15_P2.54x2.54mm_StaggerOdd_Lead4.58mm_Vertical
R1: 10K; R_0402_1005Metric
RL1: KA78M05_TO252; TO-252-2
U1: ATmega328P-A; TQFP-32_7x7mm_P0.8mm
Y1: Crystal; Crystal_SMD_0603-2Pin_6.0x3.5mm

Connections:
/5-12V: C2.1, D5.1 (K), D6.1 (K), D7.1 (K), D8.1 (K), J_MAIN_POWER1.1, MotorFET1.4 (Vs), RL1.1 (VI)
Earth: C1.2, C2.2, C3.1, C4.1, D1.2 (A), D2.2 (A), D3.2 (A), D4.2 (A), J1.1, J_MAIN_POWER1.2, MotorFET1.1 (SENSE_A), MotorFET1.8 (GND), MotorFET1.15 (SENSE_B), RL1.2 (GND), U1.3 (GND), U1.5 (GND), U1.21 (GND)
INO_D5: MotorFET1.12 (IN4), U1.9 (PD5)
INO_D6: MotorFET1.11 (EnB), U1.10 (PD6)
INO_D7: MotorFET1.10 (IN3), U1.11 (PD7)
INO_D8: MotorFET1.7 (IN2), U1.12 (PB0)
INO_D9: MotorFET1.6 (EnA), U1.13 (PB1)
INO_D10: MotorFET1.5 (IN1), U1.14 (PB2)
unnamed: C3.2, U1.7 (XTAL1/PB6), Y1.2
unnamed: C4.2, U1.8 (XTAL2/PB7), Y1.1
unnamed: D1.1 (K), D5.2 (A), J_FRONT1.1, MotorFET1.2 (OUT1)
unnamed: D2.1 (K), D6.2 (A), J_FRONT1.2, MotorFET1.3 (OUT2)
unnamed: D3.1 (K), D7.2 (A), J_BACK1.1, MotorFET1.13 (OUT3)
unnamed: D4.1 (K), D8.2 (A), J_BACK1.2, MotorFET1.14 (OUT4)
unnamed: J1.3, U1.1 (PD3)
unnamed: R1.2, U1.29 (~RESET/PC6)
VCC: C1.1, J1.2, MotorFET1.9 (Vss), R1.1, RL1.3 (VO), U1.4 (VCC), U1.6 (VCC), U1.18 (AVCC), U1.20 (AREF)

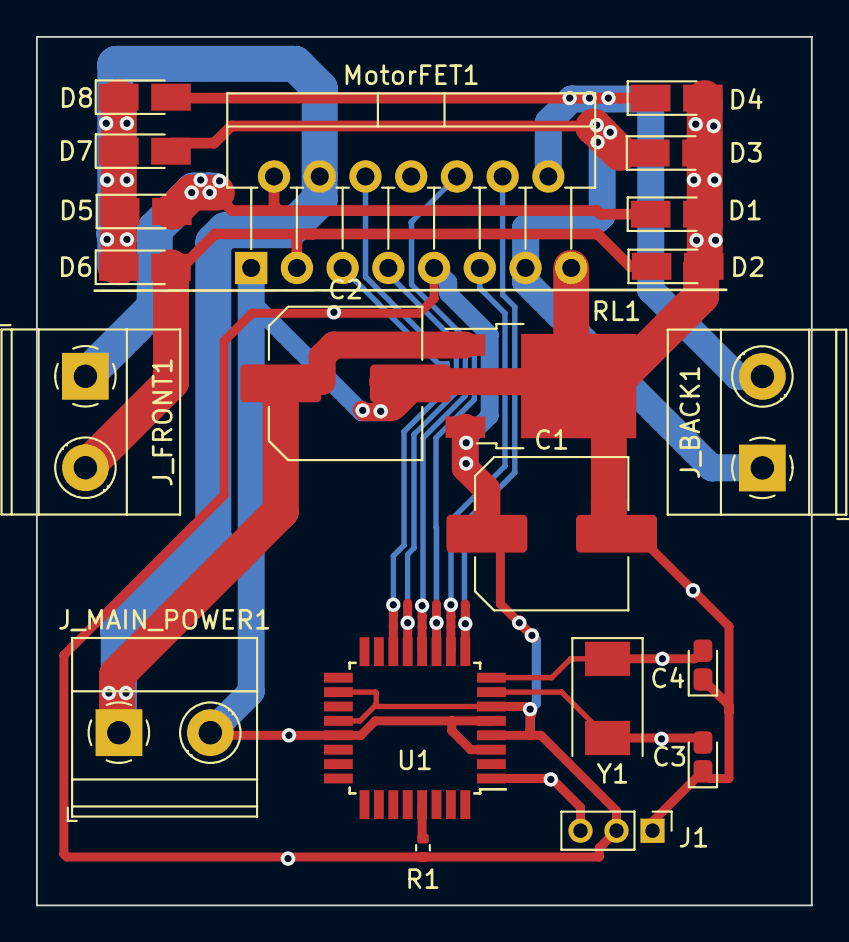
[picture p45: board JeepPCB.kicad_pcb from above]

Board: 2 copper layers, 43.0 x 48.2 mm, 21 parts (0 on the bottom side), 17 nets.
