GiovanniRaseraF/DroneTheory/(commit log)

2022-05-27 Init
    Creazione del file di progetto
2022-05-27 Init
    Test di funzionamento
2022-05-27 Errori di ortografia
2022-05-27 Test di STM32CubeIDE
2022-05-27 Aggiunto del tast di modifica dello Script di download della toolchain
2022-05-28 Test di compilazione su MacOS
2022-05-28 Aggiunta del lavoro sul file di download.sh
2022-05-29 Download della toolchain
    Funziona il download di una versione specifica
2022-05-30 Aggiunta delle compilazione di un file generico
2022-05-30 Aggiornamento del file di download.sh
    Adesso è possibile scaricare la toolchain anche su macOS
    ISSUE: https://github.com/GiovanniRaseraF/DroneTheory/issues/5
2022-05-31 Test di CMake
    Sono stati fatti dei test per capire come viene compilato inav tramite CMake
2022-05-31 Test di CMake
2022-05-31 Test di cmake funzionante
2022-05-31 Aggiunta dei file di makefile
2022-05-31 Aggiornamento del make in modo da eseguire il download
2022-06-01 Test di generazione di un segnale PWM
2022-06-01 Pulizia della cartella di test
2022-06-02 Test di scrittura su porta seriale
2022-06-02 Test di astyle
2022-06-02 Test di invio e ricezione attraverso porta UART2
2022-06-02 Ulteriori Test di comunicazione UART
2022-06-03 Test di UART con iterrupt
    Il prossimo passo è leggere UART utilizzando DMA
2022-06-04 Aggiornamento e test di UART e comunicazione con console printf()
2022-06-06 Aggiunta di un link utile
2022-06-07 Output PWM su stm32
2022-06-08 Lettura gyro da stm32
2022-06-08 Test di lettura della ricevente da arduino
2022-06-09 Test di IBUS su STM32
2022-06-09 Link per il collegamento di ricevente a betaflight
2022-06-10 Lettura e scrittura del segnale PPM nei motori
2022-06-14 Aggiunta Schematica e README
2022-06-15 Scrittura di SimplePPM
2022-06-16 Implementazione della macchina a stati per lettura di PPM
2022-06-16 Lettura della radio PPM con interrupt
2022-06-17 Inizio di SPPM Smoother
2022-06-17 Creazione del PCB della Jeep Radiocomandata
    [JeepPCB.kicad_pcb, JeepPCB.kicad_sch]
2022-06-18 Modello del PCB della Jeep iniziato
    [JeepPCB.kicad_pcb, JeepPCB.kicad_sch, Transistor L298N.step]
2022-06-20 Creazione del PCB personalizzato
    Design in KiCad e rimozione delle componenti necessarie
    [JeepPCB.kicad_pcb, JeepPCB.kicad_sch]
2022-06-20 Modello 3D del FET
    [JeepPCB.kicad_pcb, JeepPCB.kicad_sch]
2022-06-20 Aggiunta della CPU ATmega328P
    [JeepPCB.kicad_pcb, JeepPCB.kicad_sch]
2022-06-21 Aggiornamento del PCB
    [JeepPCB.kicad_pcb, JeepPCB.kicad_sch]
2022-06-21 Aggiornamento PCB Jeep
    Aggiunta delle connessioni necessarie per il processore
    [JeepPCB.kicad_pcb, JeepPCB.kicad_sch]
2022-06-21 Aggiornamento della resistenza da 10K e posizionamento dei componenti
    [JeepPCB.kicad_pcb, JeepPCB.kicad_sch]
2022-06-22 Collegamento delle tracce
    [JeepPCB.kicad_pcb, JeepPCB.kicad_sch]
2022-06-23 Modifiche alla scheda
    [JeepPCB.kicad_pcb]
2022-06-23 Aggiornamento delle tracce
    [JeepPCB.kicad_pcb, JeepPCB.kicad_sch]
2022-06-24 Jeep Finita
    [JeepPCB.kicad_pcb, JeepPCB.kicad_sch]
2022-06-24 Test di aggiunta testpad
    [JeepPCB.kicad_pcb, JeepPCB.kicad_sch]
2022-06-26 Spostamento dei DIODI per dare più spazio alla saldatura
    [JeepPCB.kicad_pcb]
2022-06-27 Collegamenti di Atmega328 più chiari
2022-06-28 Aggiornamento del PCB aggiunta di VCC e di Vie
    [JeepPCB.kicad_pcb, JeepPCB.kicad_sch]
2022-06-28 Caricamento del file Gerber
    [JeepPCB-B_Cu.gbr, JeepPCB-B_Mask.gbr, JeepPCB-B_Paste.gbr, JeepPCB-B_Silkscreen.gbr, JeepPCB-Edge_Cuts.gbr, JeepPCB-F_Cu.gbr, JeepPCB-F_Mask.gbr, JeepPCB-F_Paste.gbr]
2022-06-28 File gerber e file dei fori
    [JeepPCB-B_Cu.gbr, JeepPCB-B_Mask.gbr, JeepPCB-B_Paste.gbr, JeepPCB-B_Silkscreen.gbr, JeepPCB-Edge_Cuts.gbr, JeepPCB-F_Cu.gbr, JeepPCB-F_Mask.gbr, JeepPCB-F_Paste.gbr]
2022-06-29 Foot Print del processore a 8 bit che verrà utilizzato al posto di ATMega328P
    [JeepPCB.kicad_sch, STM8S003F3P6TR.step, stm8s003f3p6tr.stp]
2022-06-30 Creazione di una scheda per il corso
    [HWCorso.kicad_pcb, HWCorso.kicad_sch, STM32F401RCT6.step]
2022-06-30 Aggiunta dei filtri negli input e Cristallo
    [HWCorso.kicad_sch]
2022-07-01 Creazione della scheda del flight controller
    [HWCorso.kicad_sch]
2022-07-01 Scelta componenti e creazione PCD
    [HWCorso.kicad_pcb, HWCorso.kicad_sch]
2022-07-01 Posizionamento dei componenti
    [HWCorso.kicad_pcb, HWCorso.kicad_sch]
2022-07-04 Layout della scheda
    [HWCorso.kicad_pcb, HWCorso.kicad_sch]
2022-07-05 Routing della scheda
    [HWCorso.kicad_pcb, HWCorso.kicad_sch]
2022-07-05 File BOM e traduzione del file XML in csv
    [HWCorso-B_Cu.gbr, HWCorso-B_Mask.gbr, HWCorso-B_Paste.gbr, HWCorso-B_Silkscreen.gbr, HWCorso-Edge_Cuts.gbr, HWCorso-F_Cu.gbr, HWCorso-F_Mask.gbr, HWCorso-F_Paste.gbr]
2022-07-05 xml BOM parser
    [BOM.csv]
2022-07-05 Eliminazioni di alcuni file vecchi, aggiunta di una cartella con script utili
    [STM8S003F3P6TR.step, stm8s003f3p6tr.stp]
2022-07-06 Creazione della prima versione della scheda del Drone
    [BOM.csv, Connectivity.kicad_sch, DroneHardware.kicad_pcb, DroneHardware.kicad_sch, Gyro.kicad_sch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]
2022-07-06 Inizio collegamenti MPU-6000
    [Connectivity.kicad_sch, DroneHardware.kicad_sch, Gyro.kicad_sch, MCU.kicad_sch]
2022-07-06 Aggiornamento Aggiunta della MPU-6050 per test
    E' stato fatto uno studio per capire il funzionamento di OMNIBUSF4
    [DroneHardware.kicad_pcb, DroneHardware.kicad_sch, Gyro.kicad_sch, MCU.kicad_sch, Power.kicad_sch]
2022-07-07 Creazione PCB e utilizzo di processore STM32F405
    [Connectivity.kicad_sch, DroneHardware.kicad_pcb, DroneHardware.kicad_sch, Gyro.kicad_sch, MCU.kicad_sch, Power.kicad_sch]
2022-07-07 Creazione dei bordi della scheda e posizionamento dei componenti importanti
    [DroneHardware.kicad_pcb]
2022-07-08 Modifica della porta USB
    [Connectivity.kicad_sch, DroneHardware.kicad_pcb, DroneHardware.kicad_sch, MCU.kicad_sch, Power.kicad_sch]
2022-07-09 Utilizzo di mpu-6000
    [DroneHardware.kicad_pcb, DroneHardware.kicad_sch, Gyro.kicad_sch]
2022-07-09 Da eliminare
    [Gyro.kicad_sch, MCU.kicad_sch]
2022-07-09 Collegamento corretto di mpu-6000
    [DroneHardware.kicad_pcb, Gyro.kicad_sch, MCU.kicad_sch, Power.kicad_sch]
2022-07-10 Collegamento fisico di MPU-6000
    [DroneHardware.kicad_pcb, Gyro.kicad_sch, MCU.kicad_sch, Power.kicad_sch]
2022-07-10 Miglioramento delle connessioni
    [DroneHardware.kicad_pcb]
2022-07-10 Posizionamento di tutte le componenti
    [DroneHardware.kicad_pcb, DroneHardware.kicad_sch, MCU.kicad_sch, Power.kicad_sch]
2022-07-10 Versione con input a 5V e regolatore dc-dc lm3940
    [Connectivity.kicad_sch, DroneHardware.kicad_pcb, DroneHardware.kicad_sch, Gyro.kicad_sch, LM3940IMP-3.3_NOPB.step, MCU.kicad_sch, Power.kicad_sch]
2022-07-11 Creazione della scheda con il convertitore da 5V a 3.3V
    [DroneHardware.kicad_pcb, Power.kicad_sch]
2022-07-11 Test per lo spostamento della porta usb
    [DroneHardware.kicad_pcb]
2022-07-11 Aggiunta dei segnali PWM
    [MCU.kicad_sch]
2022-07-12 Collegamento di USB con resistenze da 22Ohm
    [Connectivity.kicad_sch, DroneHardware.kicad_pcb, DroneHardware.kicad_sch, MCU.kicad_sch]
2022-07-12 Collegamento USB con resistenze da 22Ohm
    [DroneHardware.kicad_pcb]
2022-07-12 Collegamento di dei segnali PWM dei motori
    [Connectivity.kicad_sch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]
2022-07-23 Aggiunta di USART per RC
    [Connectivity.kicad_sch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]
2022-07-26 Pulizia delle tracce
    [DroneHardware.kicad_pcb]
2022-07-27 Aumento dello spessore delle tracce da 5V
    [DroneHardware.kicad_pcb]
2022-07-31 Aggiunta dell'alimentazine della radio e il GND
    [DroneHardware.kicad_pcb, DroneHardware.kicad_sch, Power.kicad_sch]
2022-08-01 BOM e pos file
    [Connectivity.kicad_sch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]
2022-08-02 Modifica delle componenti 0201 in componenti 0402
    [Connectivity.kicad_sch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]
2022-08-03 Collegamento 12V e 5V
2022-08-04 Scheda Vespin 1.0 fatta spampare
    [DroneHardware-B_Cu.gbr, DroneHardware-B_Mask.gbr, DroneHardware-B_Paste.gbr, DroneHardware-B_Silkscreen.gbr, DroneHardware-Edge_Cuts.gbr, DroneHardware-F_Cu.gbr, DroneHardware-F_Mask.gbr, DroneHardware-F_Paste.gbr]
2022-08-06 Utilizzo di ArduPilot
2022-08-08 Aggiunta di un TODO
2022-08-11 Aggiornamento sullo studio di ArduPilot
2022-08-12 Aggiornamento dello studio di ArduPilot
2022-08-20 Passaggio delle Vie da 0.2 a 0.4 mm
    [DroneHardware.kicad_pcb]
2022-08-21 Aggiornamento delle vie da 0.2 a 0.4 mm, mancano le vie di pwm, le vie relative a MPU6000 e relative e USB
    [DroneHardware.kicad_pcb]
2022-08-22 Utilizzo di FreeRTOS
2022-08-22 In stampa 22 agosto 2022
    [DroneHardware-B_Cu.gbr, DroneHardware-B_Mask.gbr, DroneHardware-B_Paste.gbr, DroneHardware-B_Silkscreen.gbr, DroneHardware-Edge_Cuts.gbr, DroneHardware-F_Cu.gbr, DroneHardware-F_Mask.gbr, DroneHardware-F_Paste.gbr]
2022-08-23 Aggiornamento e stampa, sbagliata di un componente
2022-08-25 Utilizzo di FreeRTOS per la creazione di threads
2022-08-25 Utilizzo di FreeRTOS su omnibusF4
2022-08-27 Utilizzo di USB per comunicazione serial: ESITO NEGATIVO
2022-08-27 Utilizzo di una UART per del debug di STM32F405
2022-09-08 Aggiunta dell'immagine del PCB di Vespin 1.0
2022-09-08 Test del PCB di Vespin 1.0
2022-09-09 Aggiunta del test del Clock di Vespin 1.0
2022-09-10 Test del timer
2022-09-11 Documentazione di Cortex-M4
2022-09-29 Test Thread ESP32 e discussione con Nicola
    [Connectivity.kicad_sch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]
