GiovanniRaseraF/DroneTheory/(notices)

Notices in the files:
SingleTests/STM32CubeIDETest/001_RTOS_SimpleIOInterfacing/Core/Src/main.cpp:
Copyright (c) 2022 STMicroelectronics.
All rights reserved.
This software is licensed under terms that can be found in the LICENSE file
